CloudEngineHub/LeRobot-Anything-U-Arm/src/simulation/mani_skill/agents/robots/humanoid/mujoco_humanoid.png

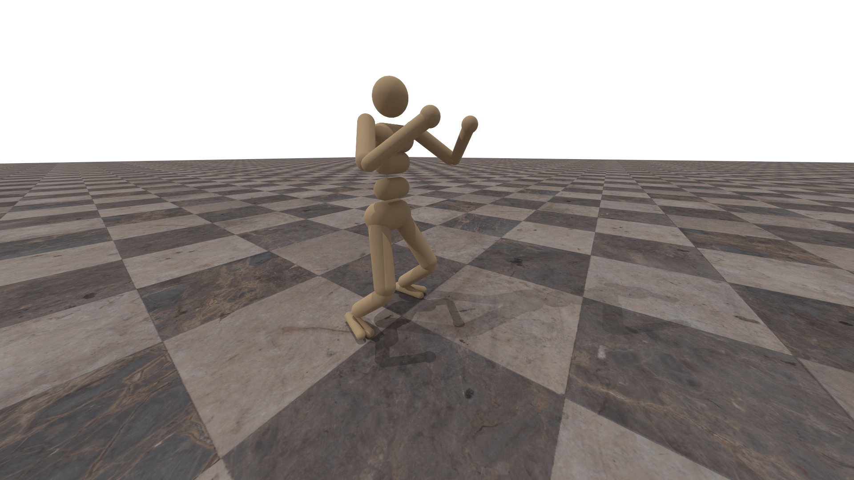
src/simulation/mani_skill/agents/robots/humanoid/mujoco_humanoid.png
