CloudEngineHub/LeRobot-Anything-U-Arm/src/simulation/mani_skill/assets/robots/fetch/fetch_description/meshes/elbow_flex_uv.png

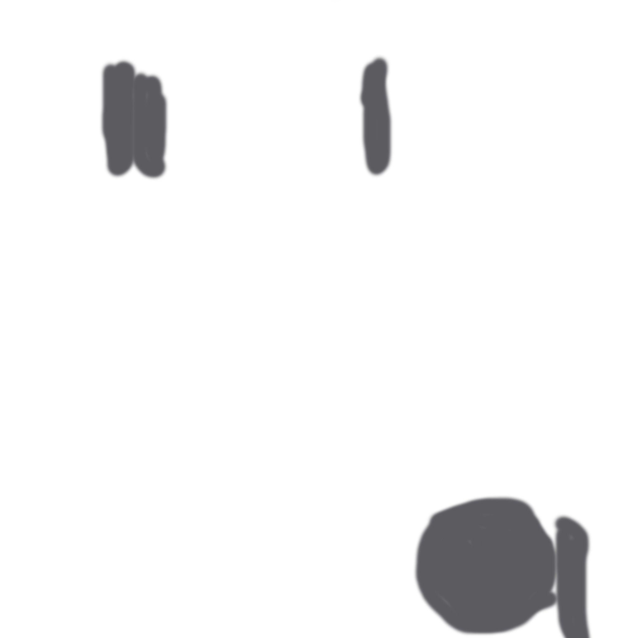
src/simulation/mani_skill/assets/robots/fetch/fetch_description/meshes/elbow_flex_uv.png
