CloudEngineHub/LeRobot-Anything-U-Arm/src/simulation/mani_skill/envs/tasks/humanoid/assets/cardboard_box/01.png

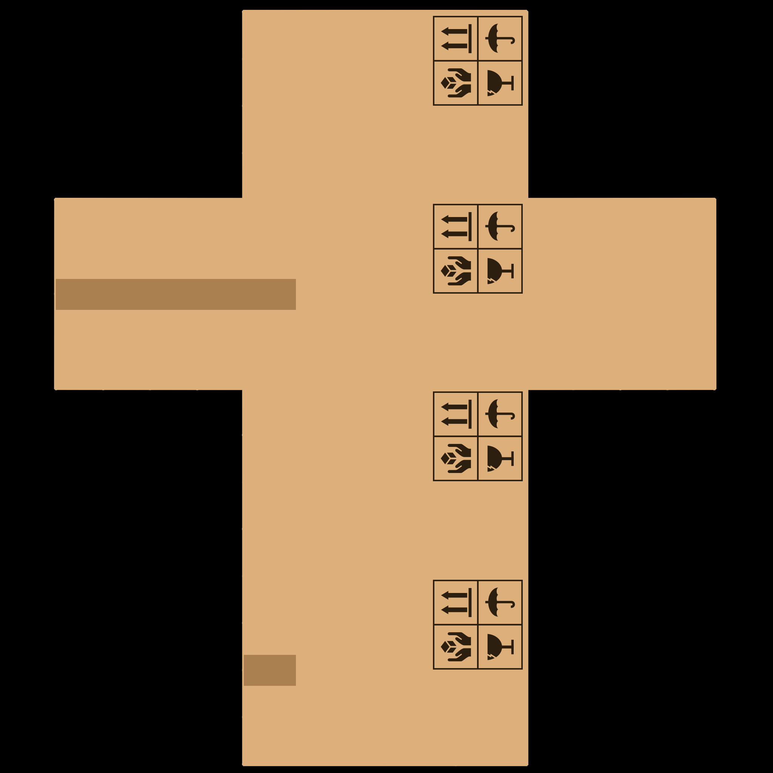
src/simulation/mani_skill/envs/tasks/humanoid/assets/cardboard_box/01.png
