CloudEngineHub/LeRobot-Anything-U-Arm/src/simulation/mani_skill/assets/robots/trifinger/robot_properties_fingers/meshes/BL-M_Table_ASM_small.stl

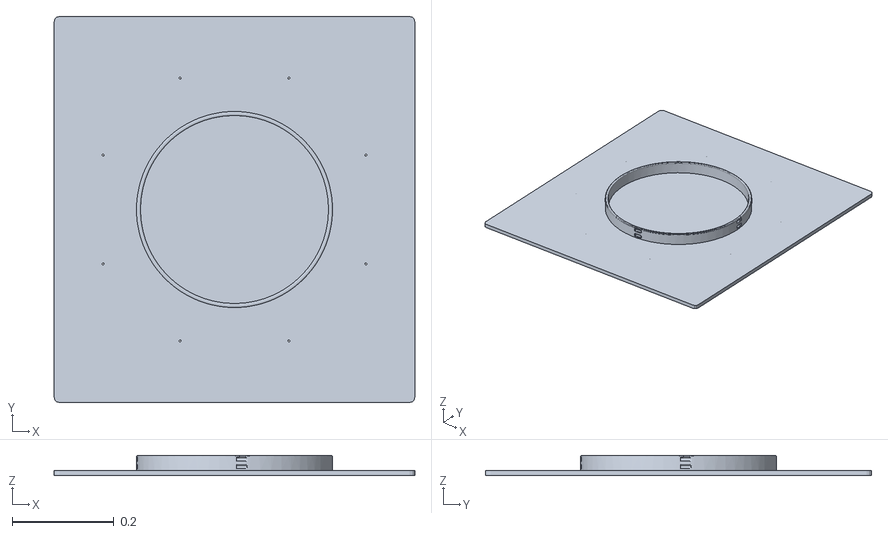
[picture p19: CAD file, 2025-08-23]
src/simulation/mani_skill/assets/robots/trifinger/robot_properties_fingers/meshes/BL-M_Table_ASM_small.stl
0.71 x 0.76 x 0.04
