CloudEngineHub/LeRobot-Anything-U-Arm/mechanical/Zhonglin_servo/dual_arm/franka_teleop_middle_bridge.STL

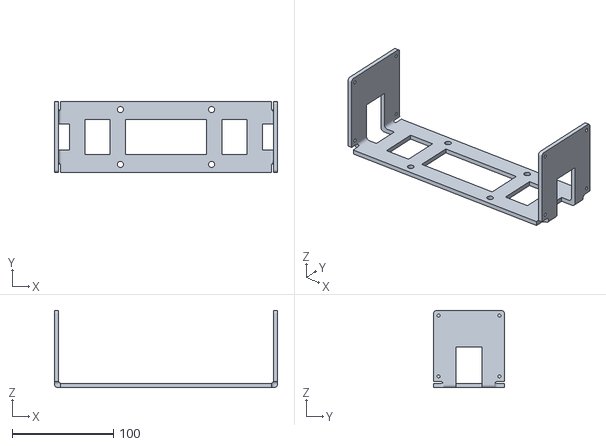
[picture p20: CAD file, 2026-03-27]
mechanical/Zhonglin_servo/dual_arm/franka_teleop_middle_bridge.STL
220.0 x 70.0 x 76.0
