CloudEngineHub/LeRobot-Anything-U-Arm/src/simulation/mani_skill/assets/robots/ability_hand/meshes/collision/thumb-F2_C.obj

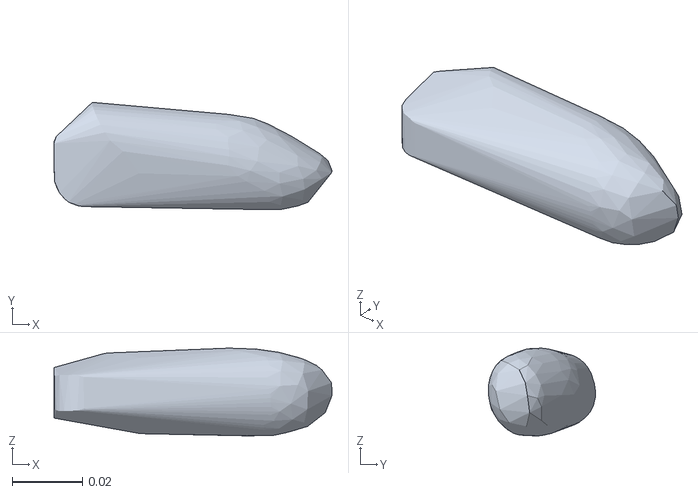
[picture p21: CAD file, 2025-08-23]
src/simulation/mani_skill/assets/robots/ability_hand/meshes/collision/thumb-F2_C.obj
0.0793 x 0.0306 x 0.025
