CloudEngineHub/LeRobot-Anything-U-Arm/src/simulation/mani_skill/assets/robots/ability_hand/meshes/visual/FB_palm_ref_MIR.obj

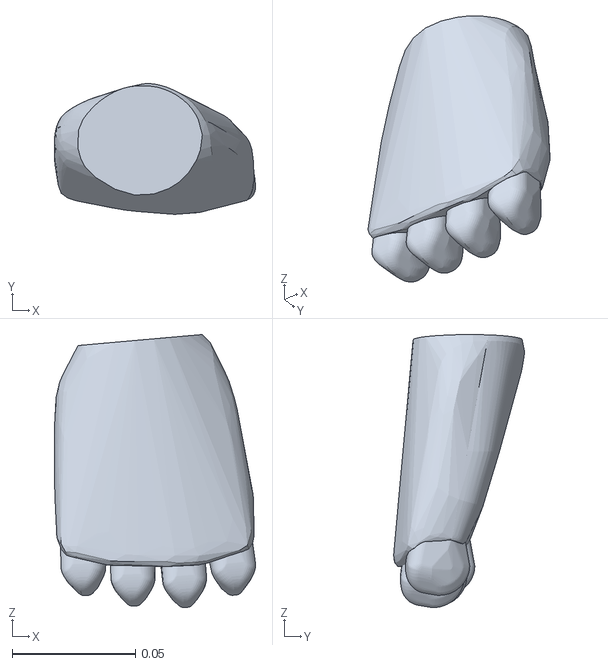
[picture p22: CAD file, 2025-08-23]
src/simulation/mani_skill/assets/robots/ability_hand/meshes/visual/FB_palm_ref_MIR.obj
0.0816 x 0.053 x 0.111
