CloudEngineHub/LeRobot-Anything-U-Arm/src/simulation/mani_skill/assets/robots/allegro/meshes/collision/link_tip.obj

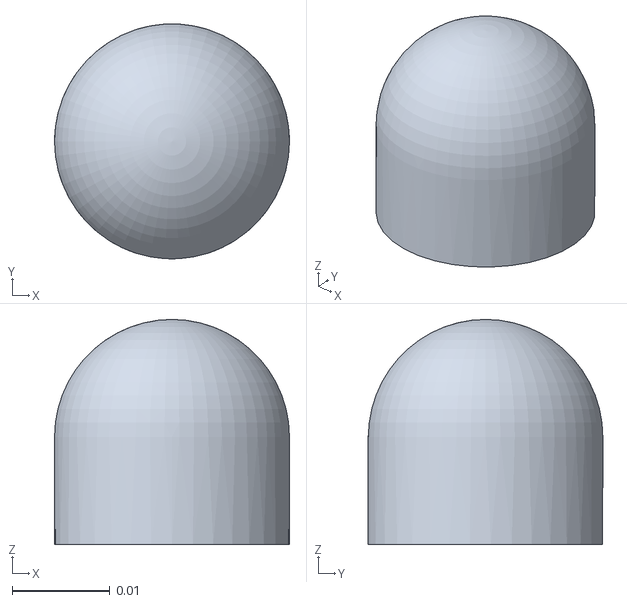
[picture p23: CAD file, 2025-08-23]
src/simulation/mani_skill/assets/robots/allegro/meshes/collision/link_tip.obj
0.024 x 0.024 x 0.023
