CloudEngineHub/LeRobot-Anything-U-Arm/src/simulation/mani_skill/assets/robots/allegro/meshes/visual/link_13.0.obj

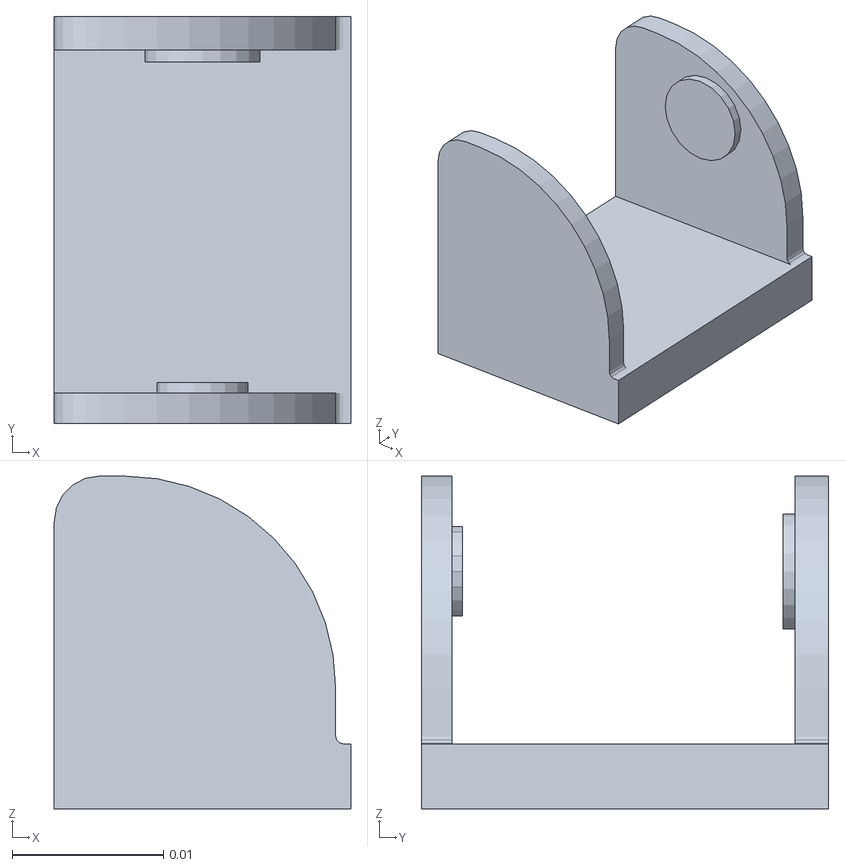
[picture p24: CAD file, 2025-08-23]
src/simulation/mani_skill/assets/robots/allegro/meshes/visual/link_13.0.obj
0.0196 x 0.0269 x 0.022
