CloudEngineHub/LeRobot-Anything-U-Arm/src/simulation/mani_skill/assets/robots/allegro/variation/meshes/collision/longer_finger_tip.obj

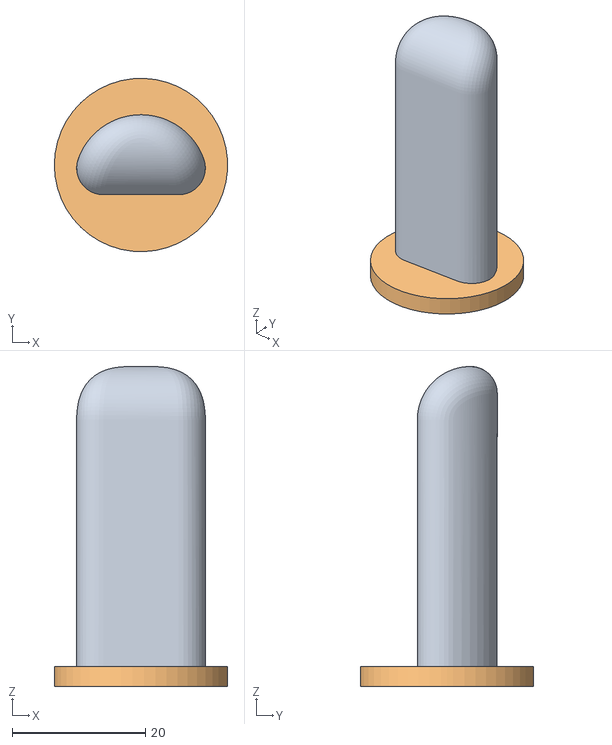
[picture p25: CAD file, 2025-08-23]
src/simulation/mani_skill/assets/robots/allegro/variation/meshes/collision/longer_finger_tip.obj
26.0 x 26.0 x 48.0
geometry_0
geometry_1
