CloudEngineHub/LeRobot-Anything-U-Arm/src/simulation/mani_skill/assets/robots/allegro/variation/meshes/visual/tactile.obj

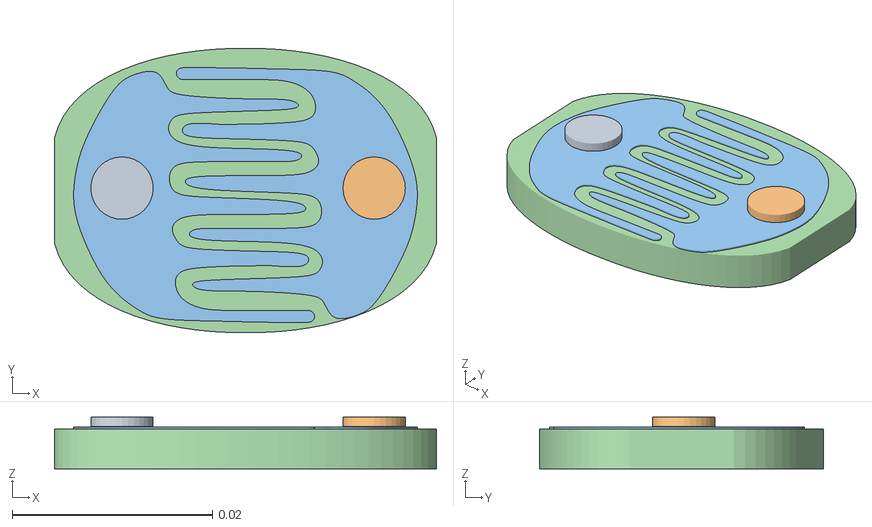
[picture p26: CAD file, 2025-08-23]
src/simulation/mani_skill/assets/robots/allegro/variation/meshes/visual/tactile.obj
0.0382 x 0.0284 x 0.00519
LIGHT_CATCHER_2
photocell
