CloudEngineHub/LeRobot-Anything-U-Arm/src/simulation/mani_skill/assets/robots/ARX-X5/meshes/link3.STL

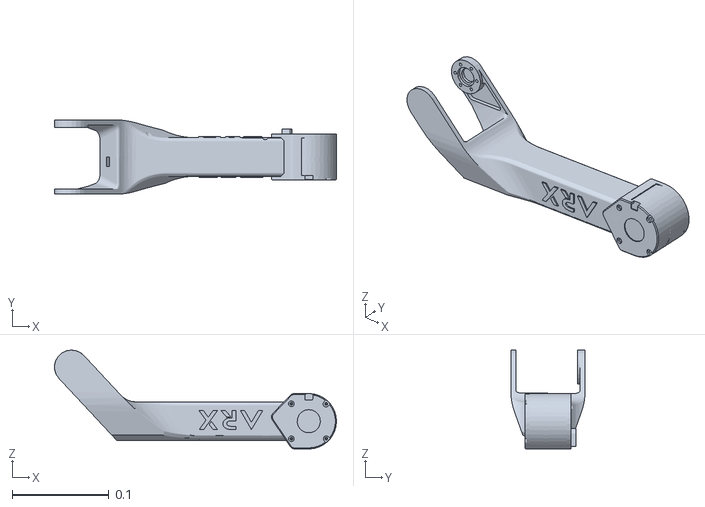
[picture p27: CAD file, 2025-08-23]
src/simulation/mani_skill/assets/robots/ARX-X5/meshes/link3.STL
0.291 x 0.0765 x 0.102
