CloudEngineHub/LeRobot-Anything-U-Arm/src/simulation/mani_skill/assets/robots/dclaw/meshes/collision/finger_tip.obj

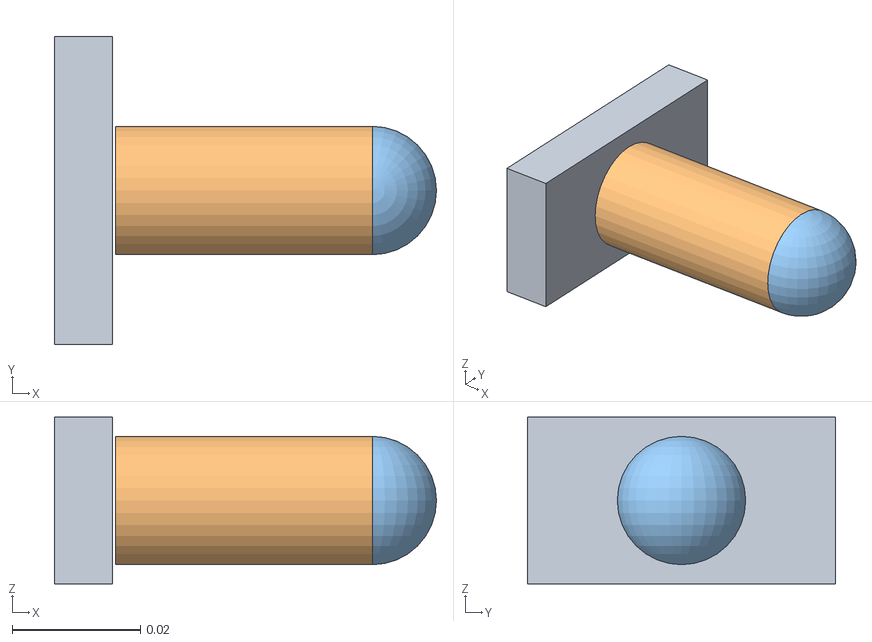
[picture p28: CAD file, 2025-08-23]
src/simulation/mani_skill/assets/robots/dclaw/meshes/collision/finger_tip.obj
0.0595 x 0.048 x 0.026
