CloudEngineHub/LeRobot-Anything-U-Arm/src/simulation/mani_skill/assets/robots/dclaw/meshes/visual/link_1.obj

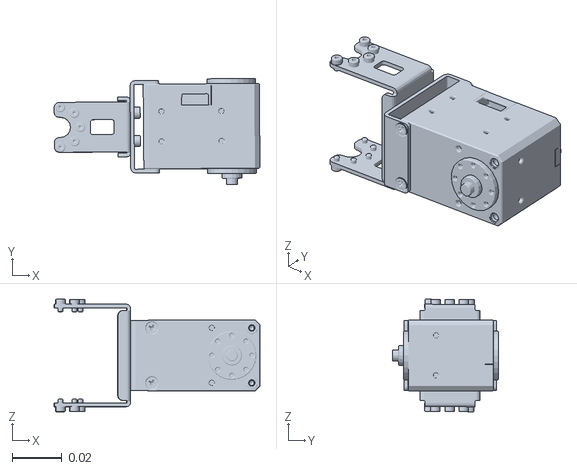
[picture p29: CAD file, 2025-08-23]
src/simulation/mani_skill/assets/robots/dclaw/meshes/visual/link_1.obj
0.0824 x 0.0425 x 0.045
