CloudEngineHub/LeRobot-Anything-U-Arm/src/simulation/mani_skill/assets/robots/fetch/fetch_description/meshes/l_gripper_finger_link.STL

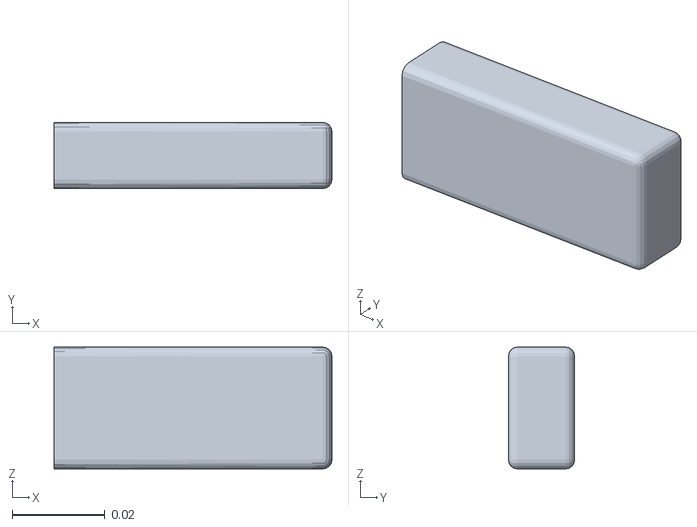
[picture p30: CAD file, 2025-08-23]
src/simulation/mani_skill/assets/robots/fetch/fetch_description/meshes/l_gripper_finger_link.STL
0.06 x 0.0143 x 0.0263
