CloudEngineHub/LeRobot-Anything-U-Arm/src/simulation/mani_skill/assets/robots/fetch_xlerobot/meshes/Fixed_Jaw_part1.ply.convex.stl

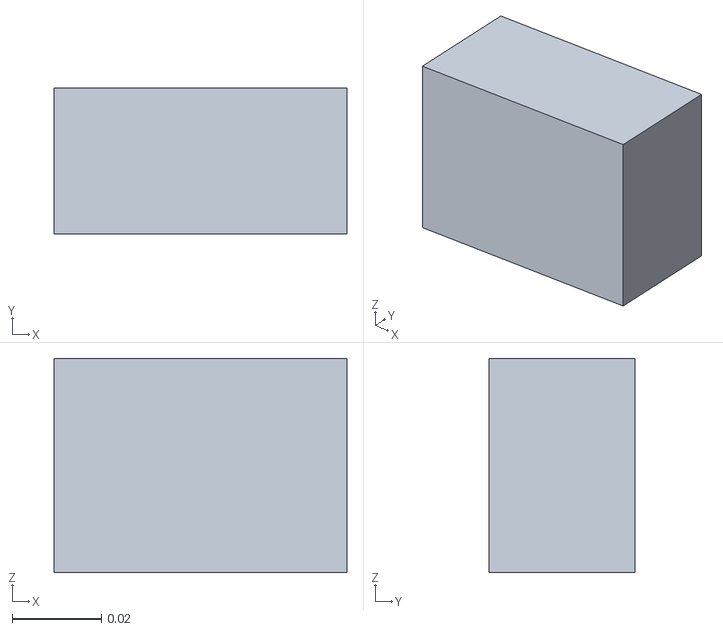
[picture p31: CAD file, 2025-08-23]
src/simulation/mani_skill/assets/robots/fetch_xlerobot/meshes/Fixed_Jaw_part1.ply.convex.stl
0.0656 x 0.0328 x 0.048
