CloudEngineHub/LeRobot-Anything-U-Arm/src/simulation/mani_skill/assets/robots/g1_humanoid/meshes/right_two_link.STL

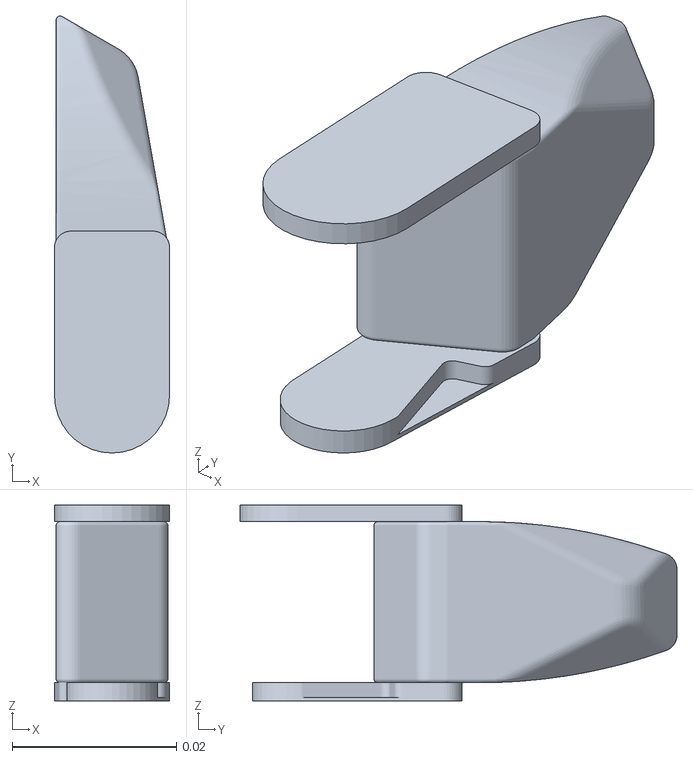
[picture p32: CAD file, 2025-08-23]
src/simulation/mani_skill/assets/robots/g1_humanoid/meshes/right_two_link.STL
0.014 x 0.0532 x 0.0238
