CloudEngineHub/LeRobot-Anything-U-Arm/src/simulation/mani_skill/assets/robots/koch/meshes/link_2.stl

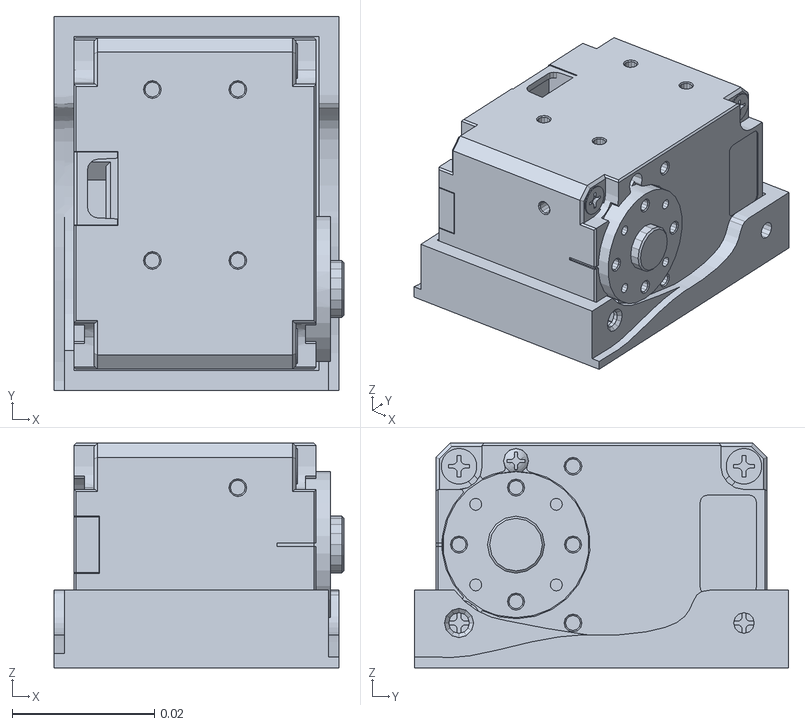
[picture p33: CAD file, 2025-08-23]
src/simulation/mani_skill/assets/robots/koch/meshes/link_2.stl
0.0407 x 0.0525 x 0.0316
