CloudEngineHub/LeRobot-Anything-U-Arm/src/simulation/mani_skill/assets/robots/panda/franka_description/meshes/collision/link6.stl.convex.stl

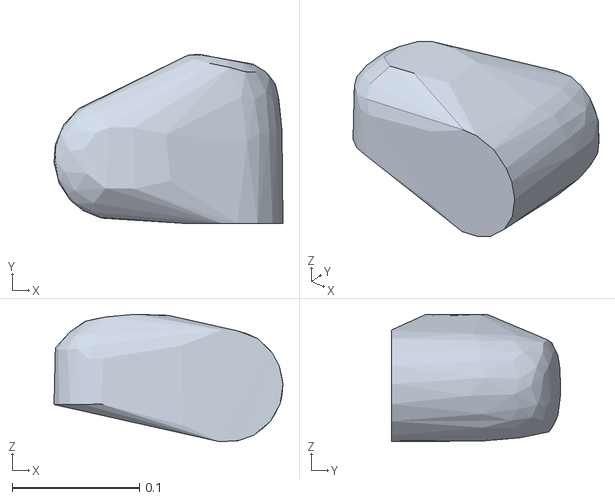
[picture p34: CAD file, 2025-08-23]
src/simulation/mani_skill/assets/robots/panda/franka_description/meshes/collision/link6.stl.convex.stl
0.18 x 0.133 x 0.1
