CloudEngineHub/LeRobot-Anything-U-Arm/src/simulation/mani_skill/assets/robots/panda/realsense2_description/meshes/plug_collision.stl

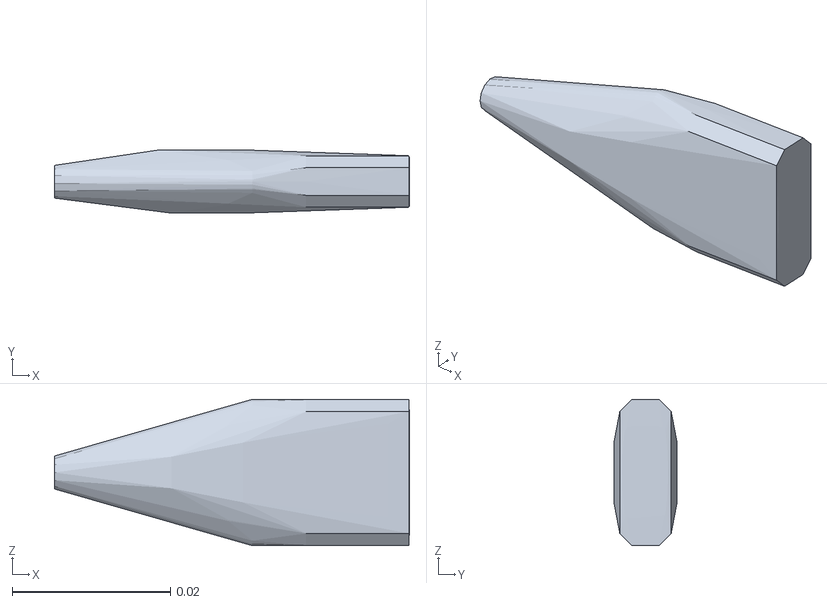
[picture p35: CAD file, 2025-08-23]
src/simulation/mani_skill/assets/robots/panda/realsense2_description/meshes/plug_collision.stl
0.0448 x 0.008 x 0.0185
