CloudEngineHub/LeRobot-Anything-U-Arm/src/simulation/mani_skill/assets/robots/panda/sciurus17_description/meshes/collision/Body.stl

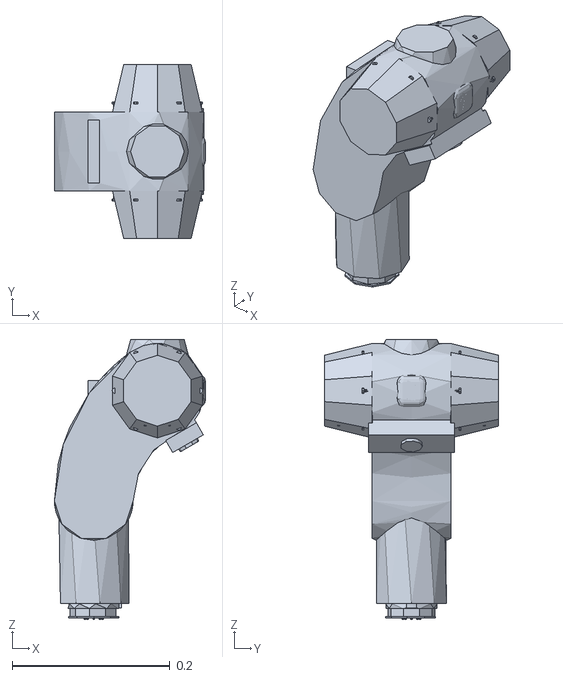
[picture p36: CAD file, 2025-08-23]
src/simulation/mani_skill/assets/robots/panda/sciurus17_description/meshes/collision/Body.stl
0.192 x 0.221 x 0.356
