CloudEngineHub/LeRobot-Anything-U-Arm/src/simulation/mani_skill/assets/robots/panda/sciurus17_description/meshes/visual/Base.stl

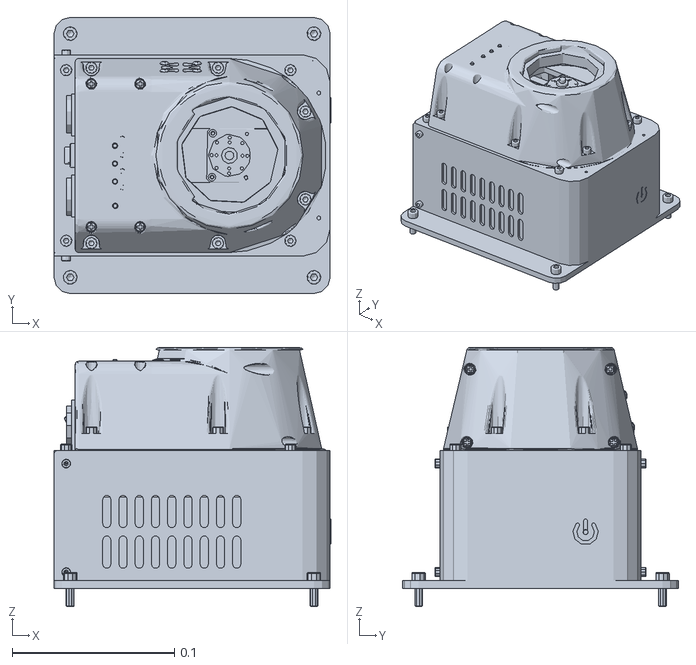
[picture p37: CAD file, 2025-08-23]
src/simulation/mani_skill/assets/robots/panda/sciurus17_description/meshes/visual/Base.stl
0.171 x 0.17 x 0.159
