CloudEngineHub/LeRobot-Anything-U-Arm/src/simulation/mani_skill/assets/robots/piper/meshes/link1.STL

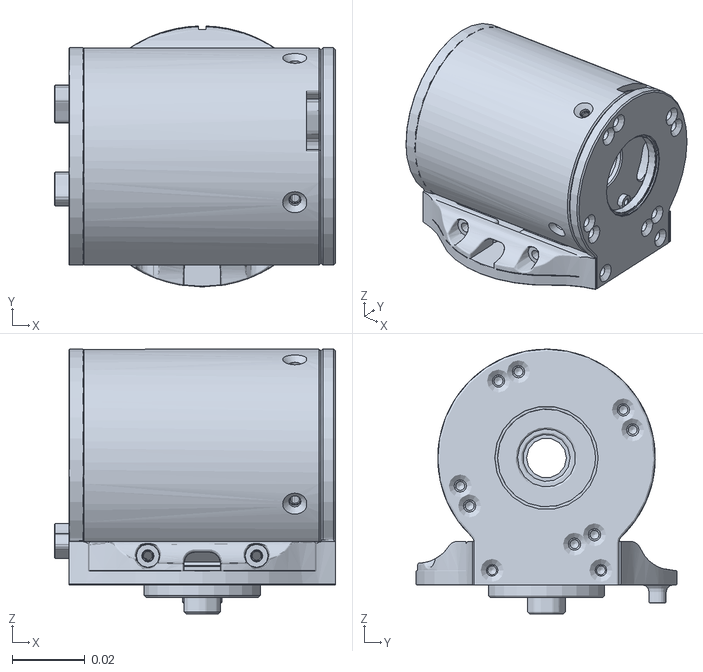
[picture p38: CAD file, 2025-08-23]
src/simulation/mani_skill/assets/robots/piper/meshes/link1.STL
0.0775 x 0.072 x 0.073
