CloudEngineHub/LeRobot-Anything-U-Arm/src/simulation/mani_skill/assets/robots/so100/meshes/Base.stl

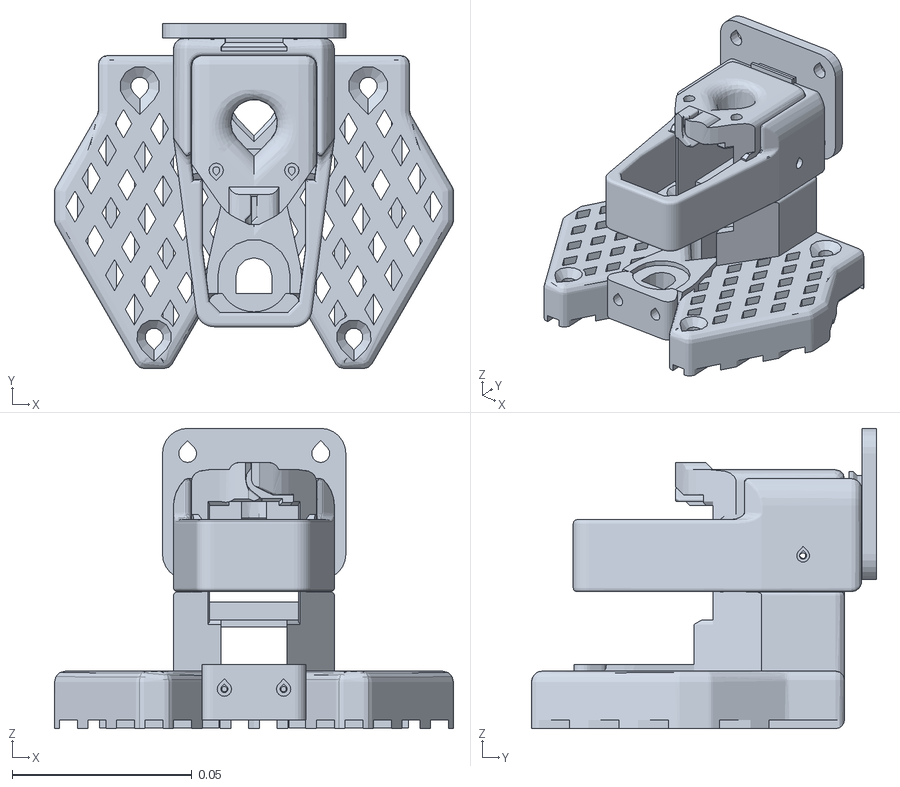
[picture p39: CAD file, 2025-08-23]
src/simulation/mani_skill/assets/robots/so100/meshes/Base.stl
0.111 x 0.0959 x 0.0835
