CloudEngineHub/LeRobot-Anything-U-Arm/src/simulation/mani_skill/assets/robots/trifinger/objects/meshes/ball.obj

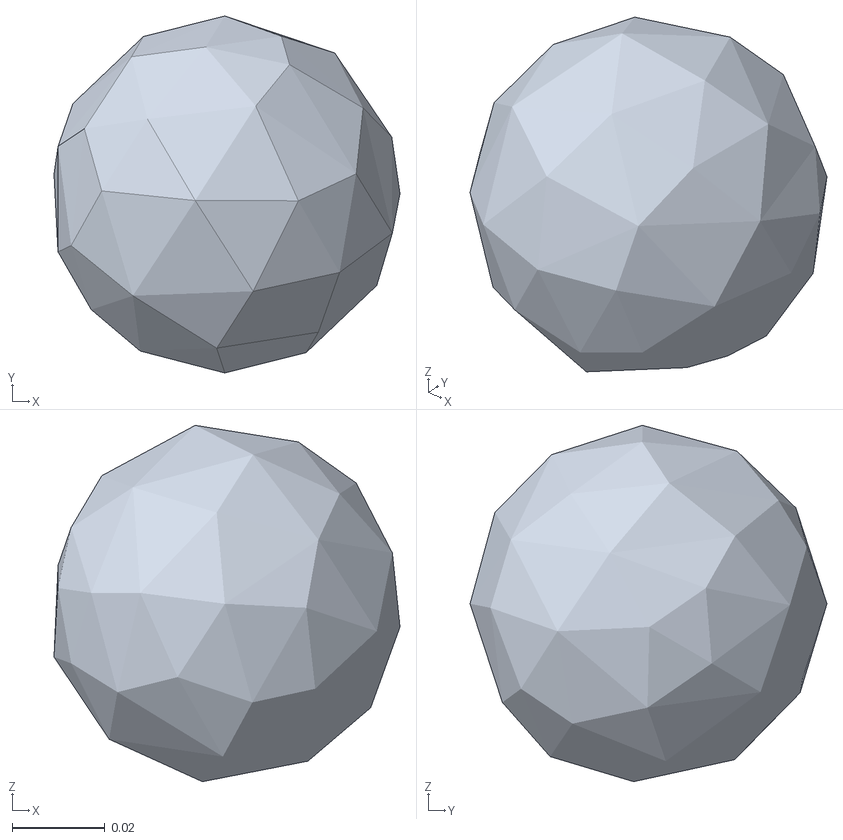
[picture p40: CAD file, 2025-08-23]
src/simulation/mani_skill/assets/robots/trifinger/objects/meshes/ball.obj
0.0745 x 0.0768 x 0.0767
