CloudEngineHub/LeRobot-Anything-U-Arm/src/simulation/mani_skill/assets/robots/trifinger/robot_properties_fingers/meshes/edu/base_side_right.stl

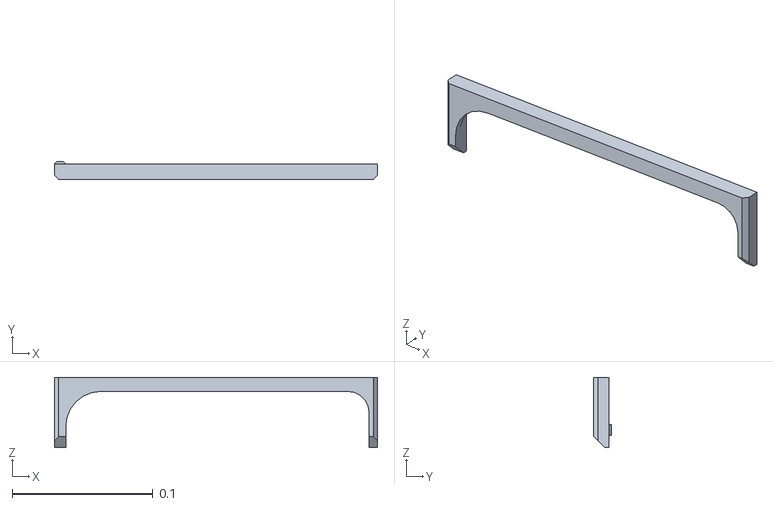
[picture p41: CAD file, 2025-08-23]
src/simulation/mani_skill/assets/robots/trifinger/robot_properties_fingers/meshes/edu/base_side_right.stl
0.229 x 0.0125 x 0.05
