CloudEngineHub/LeRobot-Anything-U-Arm/src/simulation/mani_skill/assets/robots/trifinger/robot_properties_fingers/meshes/pro/detailed/SIM__BL-Finger_Tip_without_tip.stl

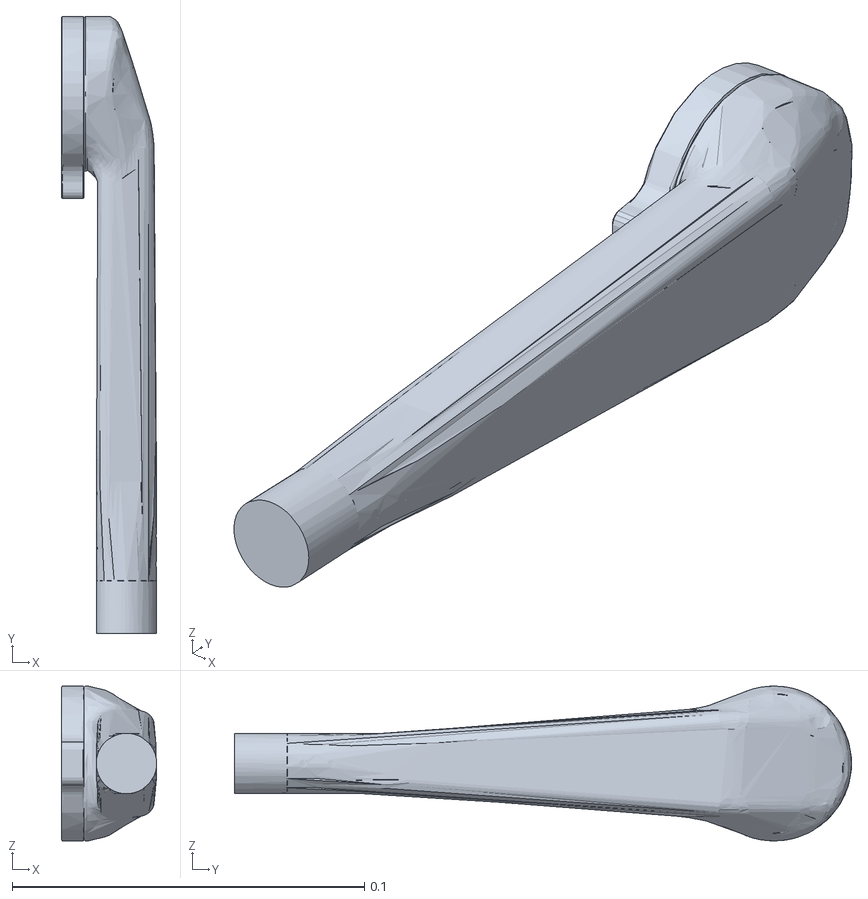
[picture p42: CAD file, 2025-08-23]
src/simulation/mani_skill/assets/robots/trifinger/robot_properties_fingers/meshes/pro/detailed/SIM__BL-Finger_Tip_without_tip.stl
0.0271 x 0.175 x 0.044
