CloudEngineHub/LeRobot-Anything-U-Arm/src/simulation/mani_skill/assets/robots/trifinger/robot_properties_fingers/meshes/pro/motor_sim.stl

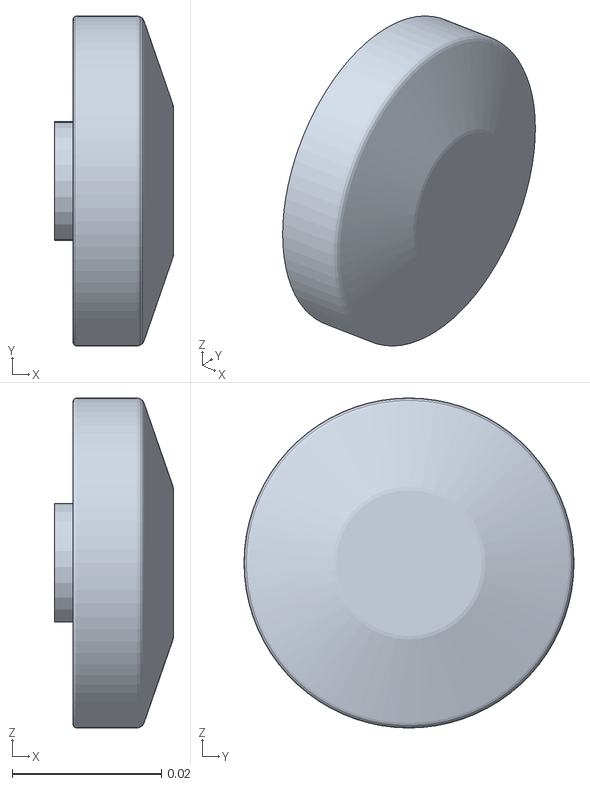
[picture p43: CAD file, 2025-08-23]
src/simulation/mani_skill/assets/robots/trifinger/robot_properties_fingers/meshes/pro/motor_sim.stl
0.016 x 0.0442 x 0.0442
