CloudEngineHub/LeRobot-Anything-U-Arm/src/simulation/mani_skill/assets/robots/trifinger/robot_properties_fingers/meshes/Tip_link_Modular_SIM.stl

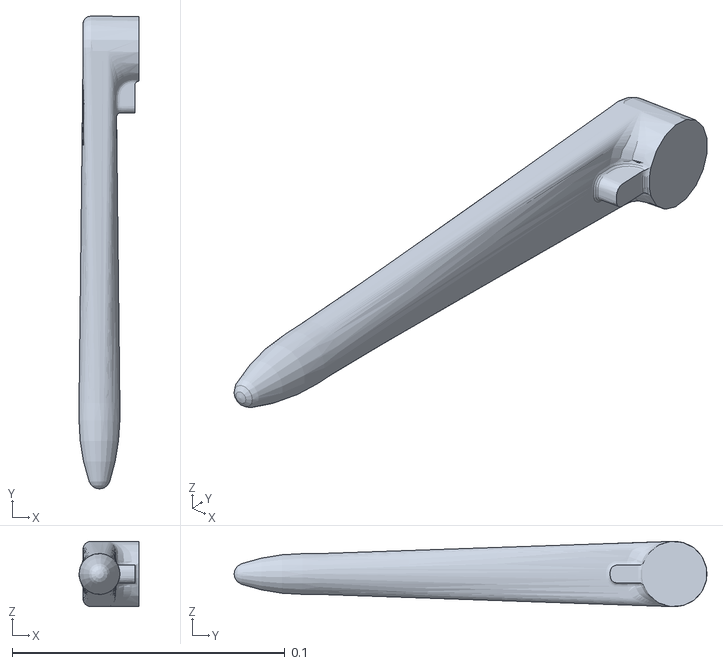
[picture p44: CAD file, 2025-08-23]
src/simulation/mani_skill/assets/robots/trifinger/robot_properties_fingers/meshes/Tip_link_Modular_SIM.stl
0.022 x 0.174 x 0.024
