CloudEngineHub/LeRobot-Anything-U-Arm/src/simulation/mani_skill/assets/robots/xarm7/meshes/collision/link2.obj

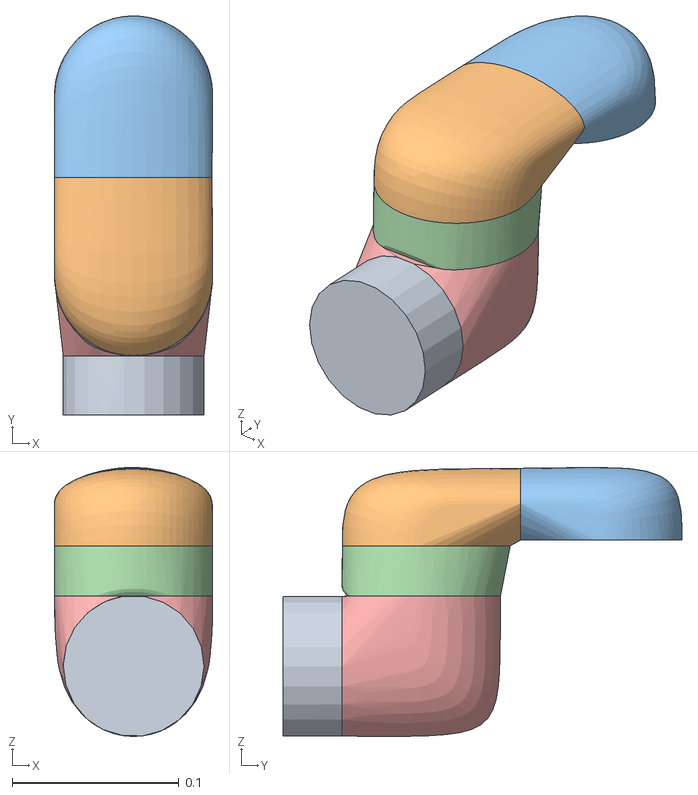
[picture p45: CAD file, 2025-08-23]
src/simulation/mani_skill/assets/robots/xarm7/meshes/collision/link2.obj
0.095 x 0.239 x 0.161
geometry_0
geometry_1
geometry_2
geometry_3
geometry_4
