CloudEngineHub/LeRobot-Anything-U-Arm/src/simulation/mani_skill/envs/tasks/fmb/assets/purple_u.ply

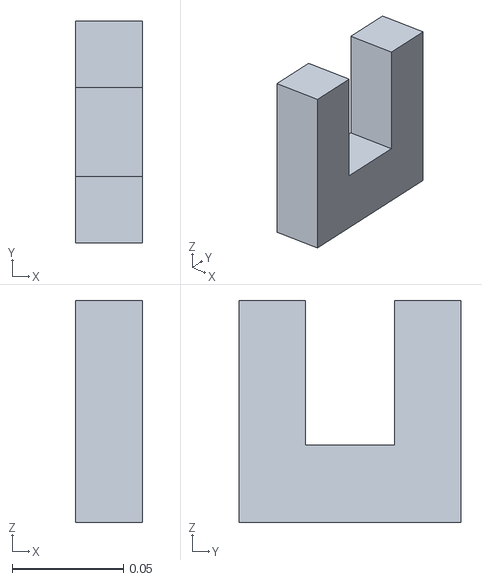
[picture p46: CAD file, 2025-08-23]
src/simulation/mani_skill/envs/tasks/fmb/assets/purple_u.ply
0.03 x 0.1 x 0.1
