CloudEngineHub/LeRobot-Anything-U-Arm/src/simulation/mani_skill/envs/tasks/humanoid/assets/apple_1.ply

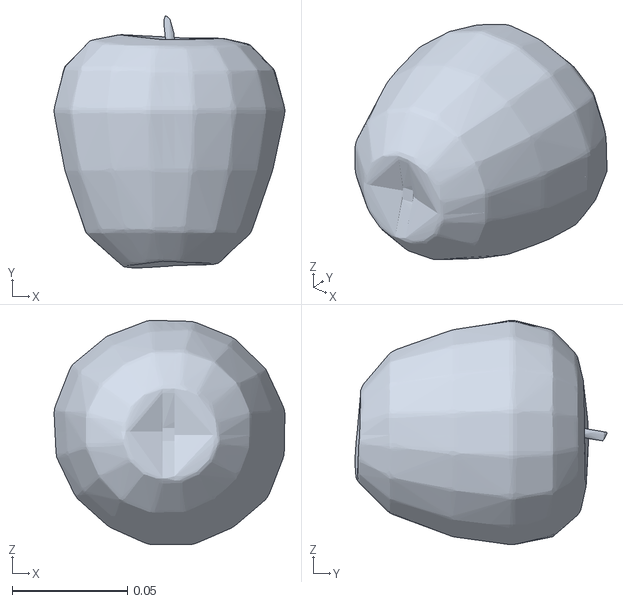
[picture p47: CAD file, 2025-08-23]
src/simulation/mani_skill/envs/tasks/humanoid/assets/apple_1.ply
0.1 x 0.11 x 0.0975
