CloudEngineHub/LeRobot-Anything-U-Arm/src/simulation/mani_skill/envs/tasks/humanoid/assets/cardboard_box/textured.obj

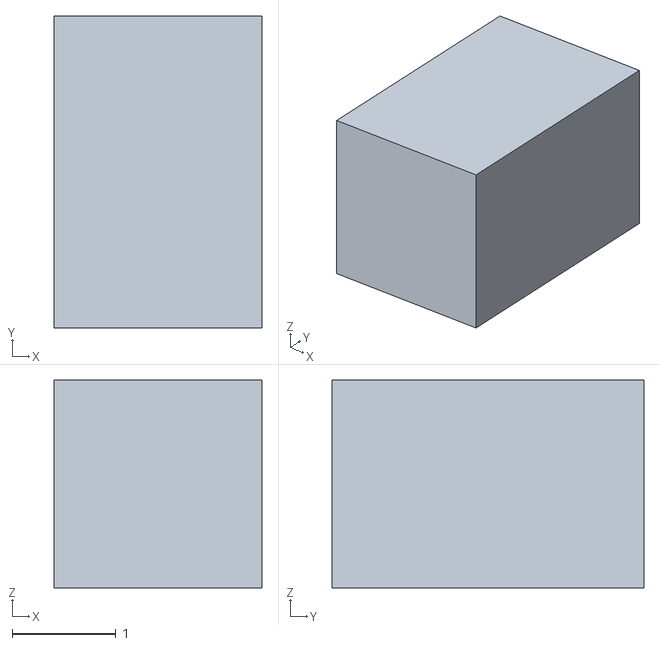
[picture p48: CAD file, 2025-08-23]
src/simulation/mani_skill/envs/tasks/humanoid/assets/cardboard_box/textured.obj
2.00 x 3.00 x 2.00
