CloudEngineHub/LeRobot-Anything-U-Arm/src/simulation/mani_skill/examples/bimanual.openarm/openarm_description/assets/end_effector/parallel_link/meshes/collision/finger.stl

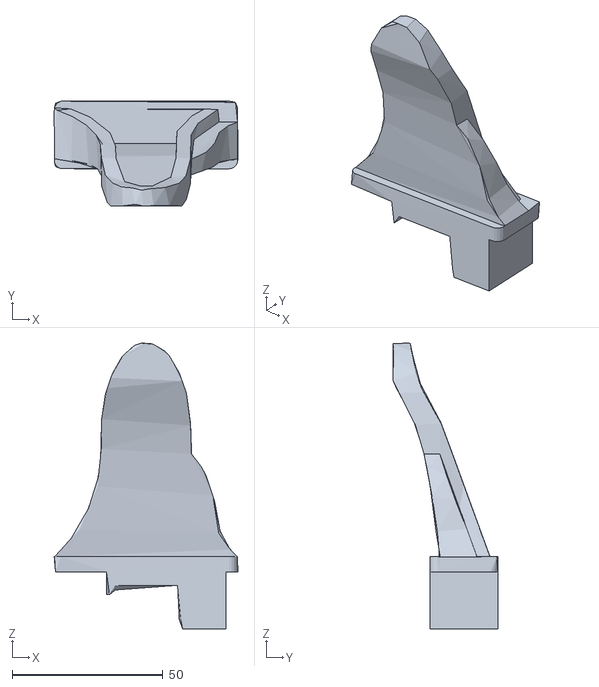
[picture p49: CAD file, 2026-07-15]
src/simulation/mani_skill/examples/bimanual.openarm/openarm_description/assets/end_effector/parallel_link/meshes/collision/finger.stl
61.0 x 34.8 x 94.9
