CloudEngineHub/LeRobot-Anything-U-Arm/src/simulation/mani_skill/examples/bimanual.openarm/openarm_description/assets/end_effector/parallel_link/meshes/visual/finger.stl

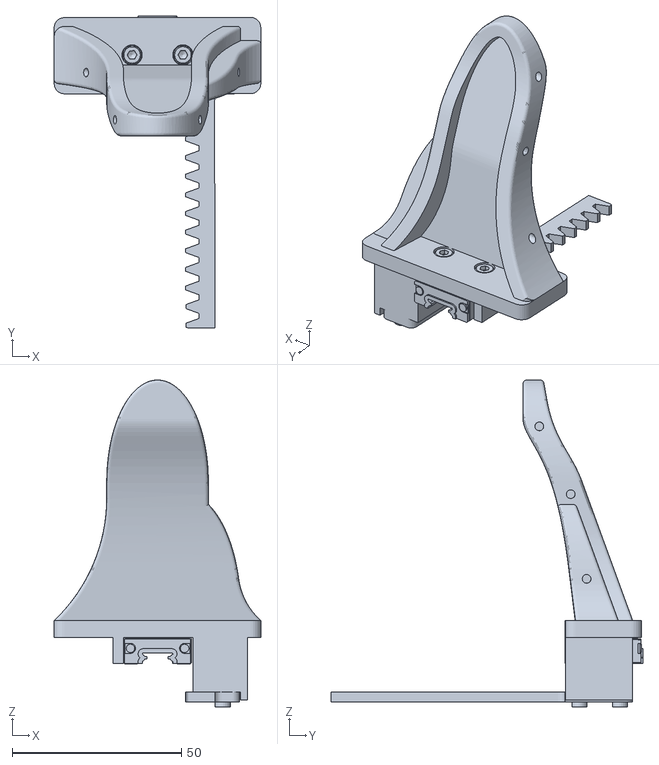
[picture p50: CAD file, 2026-07-15]
src/simulation/mani_skill/examples/bimanual.openarm/openarm_description/assets/end_effector/parallel_link/meshes/visual/finger.stl
61.0 x 92.0 x 96.5
