CloudEngineHub/LeRobot-Anything-U-Arm/src/simulation/mani_skill/examples/bimanual.openarm/openarm_description/assets/end_effector/pinch_gripper/meshes/collision/finger_outer.stl

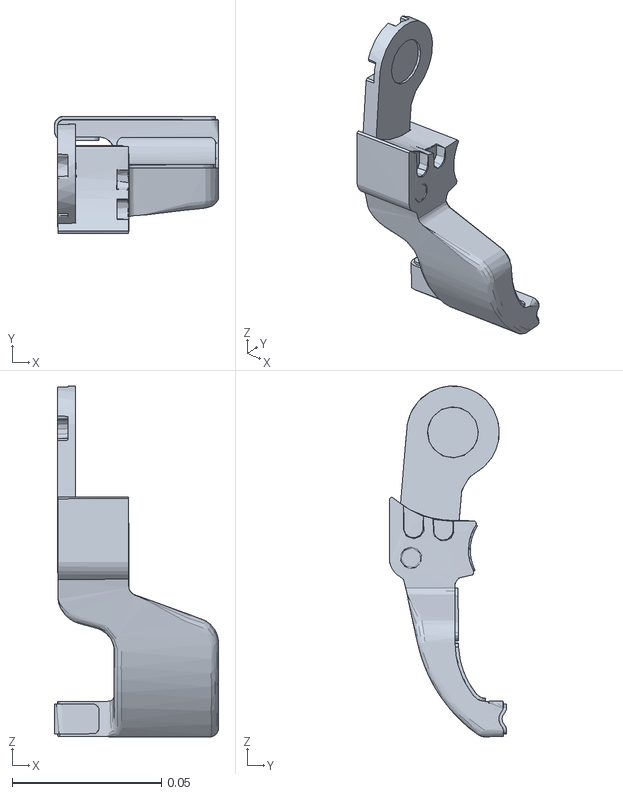
[picture p51: CAD file, 2026-07-15]
src/simulation/mani_skill/examples/bimanual.openarm/openarm_description/assets/end_effector/pinch_gripper/meshes/collision/finger_outer.stl
0.055 x 0.0393 x 0.117
