CloudEngineHub/LeRobot-Anything-U-Arm/src/simulation/mani_skill/examples/bimanual.openarm/openarm_description/assets/end_effector/pinch_gripper/meshes/collision/splited/finger_inner/finger_inner_01.stl

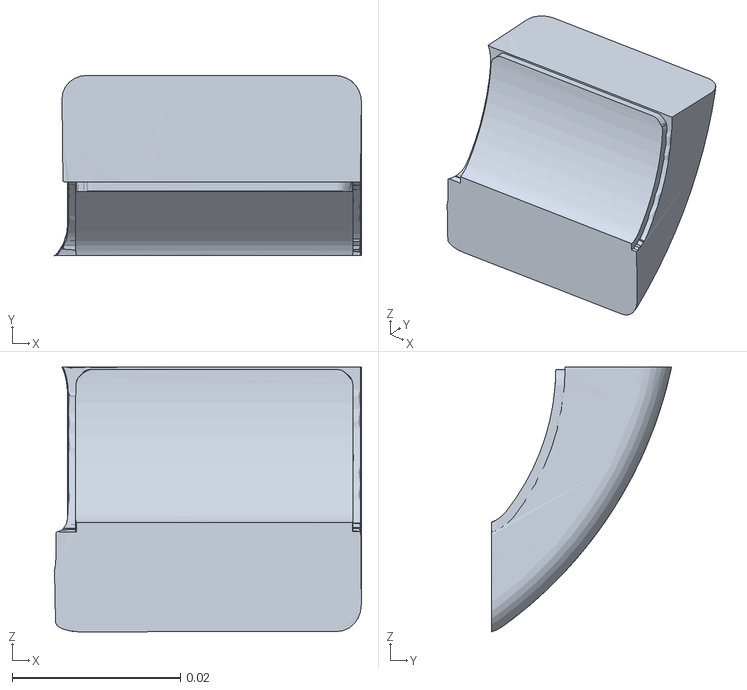
[picture p52: CAD file, 2026-07-15]
src/simulation/mani_skill/examples/bimanual.openarm/openarm_description/assets/end_effector/pinch_gripper/meshes/collision/splited/finger_inner/finger_inner_01.stl
0.0365 x 0.0214 x 0.0315
