CloudEngineHub/LeRobot-Anything-U-Arm/src/simulation/mani_skill/examples/bimanual.openarm/openarm_description/assets/end_effector/pinch_gripper/meshes/collision/splited/finger_outer/finger_outer_03.stl

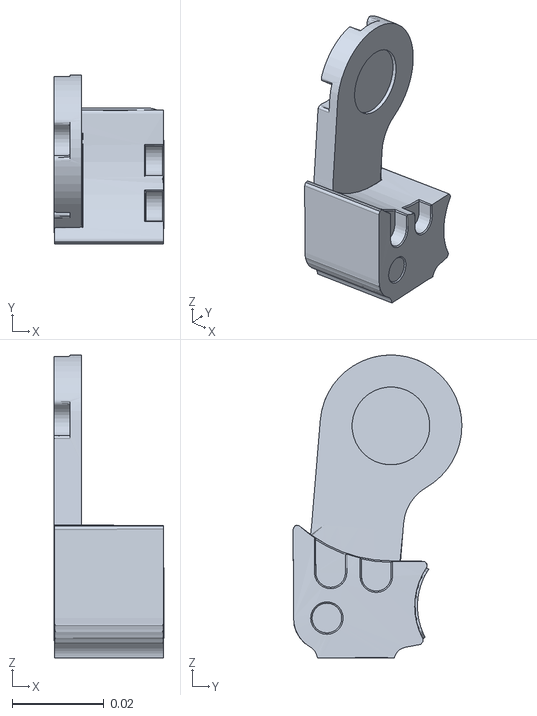
[picture p53: CAD file, 2026-07-15]
src/simulation/mani_skill/examples/bimanual.openarm/openarm_description/assets/end_effector/pinch_gripper/meshes/collision/splited/finger_outer/finger_outer_03.stl
0.024 x 0.0369 x 0.0662
