CloudEngineHub/LeRobot-Anything-U-Arm/src/simulation/mani_skill/examples/bimanual.openarm/openarm_description/assets/robot/openarm_v2.0/meshes/arm/collision/link2.stl

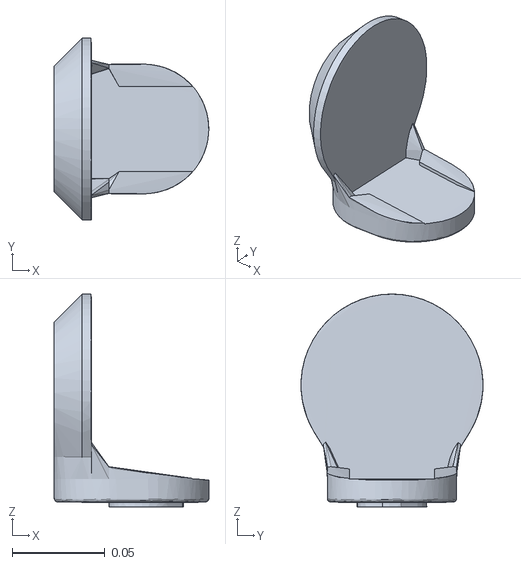
[picture p55: CAD file, 2026-07-15]
src/simulation/mani_skill/examples/bimanual.openarm/openarm_description/assets/robot/openarm_v2.0/meshes/arm/collision/link2.stl
0.0832 x 0.0979 x 0.115
