CloudEngineHub/LeRobot-Anything-U-Arm/src/simulation/mani_skill/examples/bimanual.openarm/openarm_description/assets/robot/openarm_v2.0/meshes/body/collision/body_link0_symp.stl

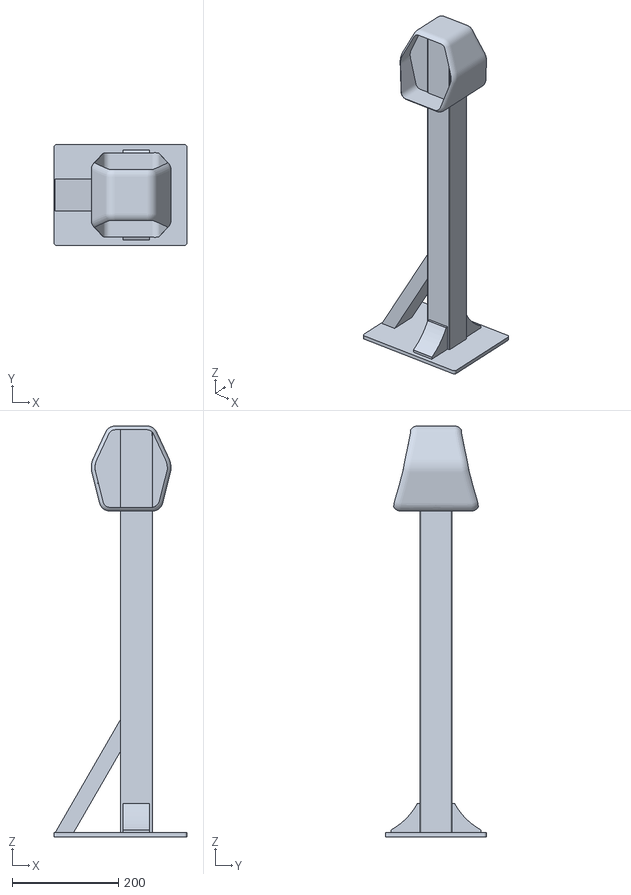
[picture p57: CAD file, 2026-07-15]
src/simulation/mani_skill/examples/bimanual.openarm/openarm_description/assets/robot/openarm_v2.0/meshes/body/collision/body_link0_symp.stl
250.0 x 190.0 x 773.0
