CloudEngineHub/LeRobot-Anything-U-Arm/src/simulation/mani_skill/examples/bimanual.openarm/openarm_description/assets/robot/openarm_v2.0/meshes/body/visual/body_link0.stl

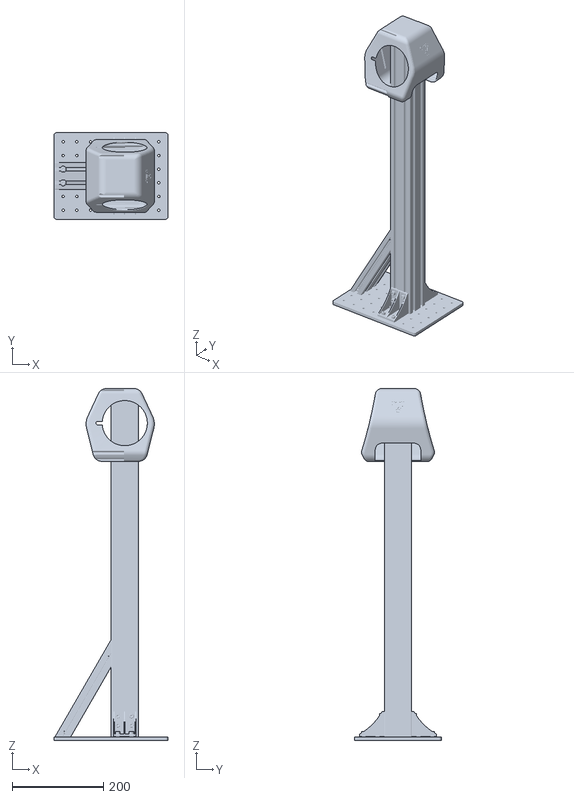
[picture p58: CAD file, 2026-07-15]
src/simulation/mani_skill/examples/bimanual.openarm/openarm_description/assets/robot/openarm_v2.0/meshes/body/visual/body_link0.stl
250.0 x 190.0 x 773.0
