CloudEngineHub/LeRobot-Anything-U-Arm/src/simulation/mani_skill/examples/bimanual.openarm/openarm_mujoco/v2/assets/collision/finger_outer_part_00.stl

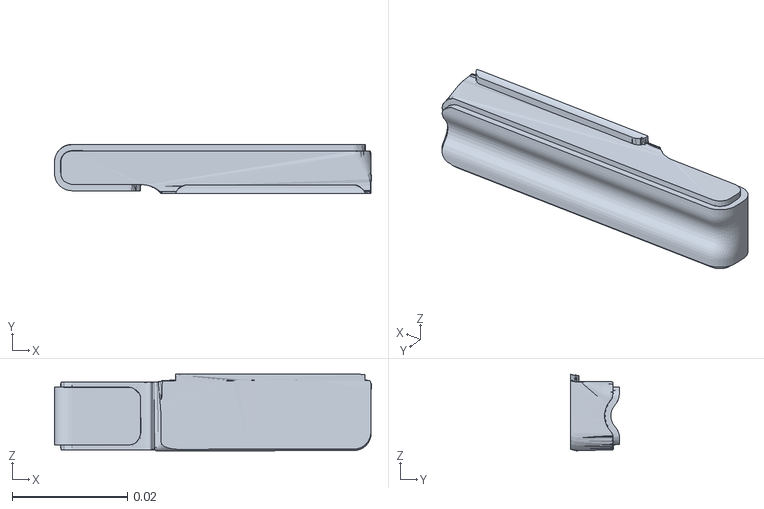
[picture p59: CAD file, 2026-07-15]
src/simulation/mani_skill/examples/bimanual.openarm/openarm_mujoco/v2/assets/collision/finger_outer_part_00.stl
0.055 x 0.00854 x 0.0133
