CloudEngineHub/LeRobot-Anything-U-Arm/src/simulation/mani_skill/examples/bimanual.openarm/openarm_mujoco/v2/assets/visual/arm/link3_02.obj

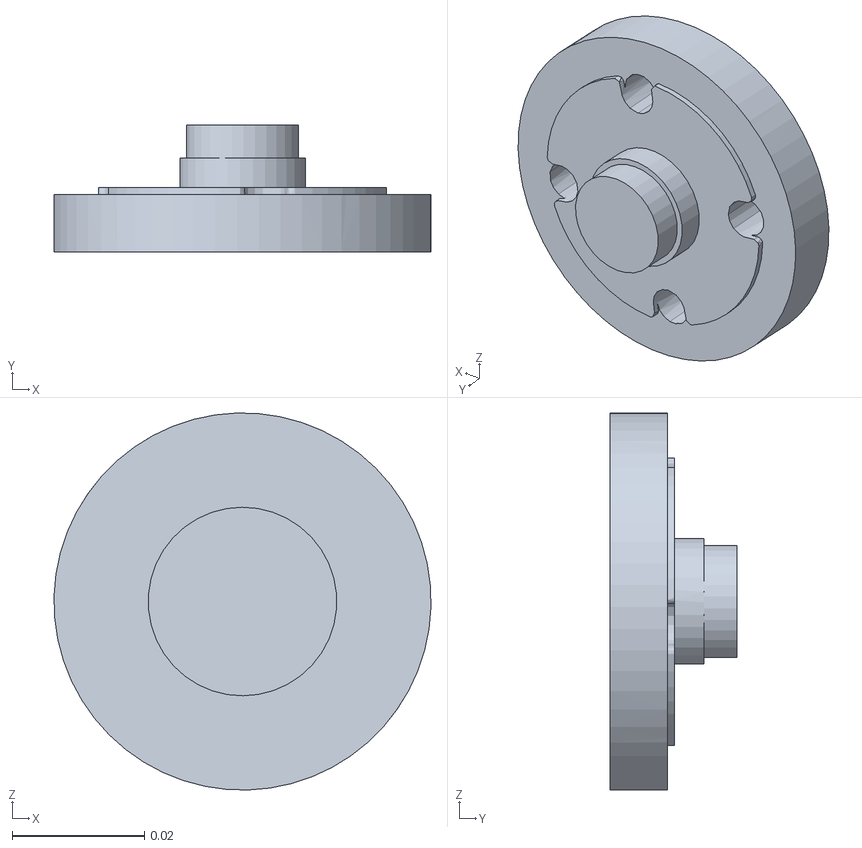
[picture p60: CAD file, 2026-07-15]
src/simulation/mani_skill/examples/bimanual.openarm/openarm_mujoco/v2/assets/visual/arm/link3_02.obj
0.057 x 0.0193 x 0.057
