CloudEngineHub/LeRobot-Anything-U-Arm/src/simulation/mani_skill/examples/bimanual.openarm/openarm_mujoco/v2/assets/visual/cell/cell.obj

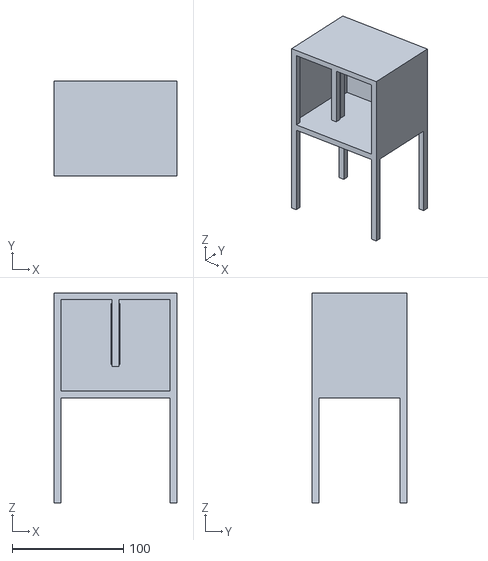
[picture p61: CAD file, 2026-07-15]
src/simulation/mani_skill/examples/bimanual.openarm/openarm_mujoco/v2/assets/visual/cell/cell.obj
110.0 x 85.0 x 188.6
