CloudEngineHub/LeRobot-Anything-U-Arm/src/simulation/mani_skill/examples/bimanual.openarm/openarm_mujoco/v2/assets/visual/gripper/ee_base_link_00.obj

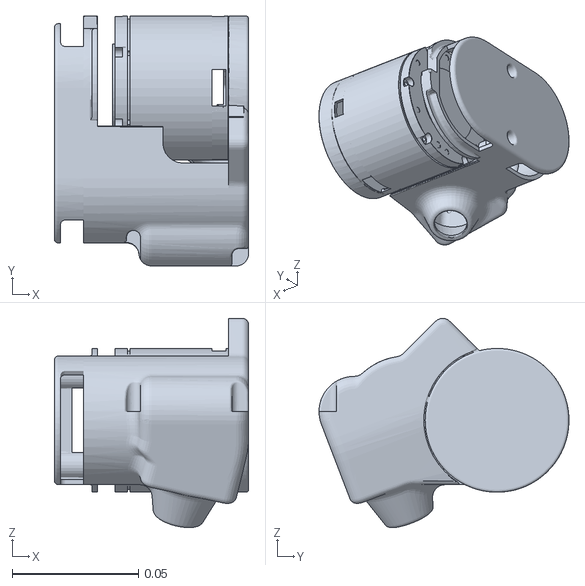
[picture p62: CAD file, 2026-07-15]
src/simulation/mani_skill/examples/bimanual.openarm/openarm_mujoco/v2/assets/visual/gripper/ee_base_link_00.obj
0.077 x 0.0991 x 0.083
