CloudEngineHub/LeRobot-Anything-U-Arm/mechanical/Zhonglin_servo/dual_arm/frank_teleop_humanoid_bimanual.STEP

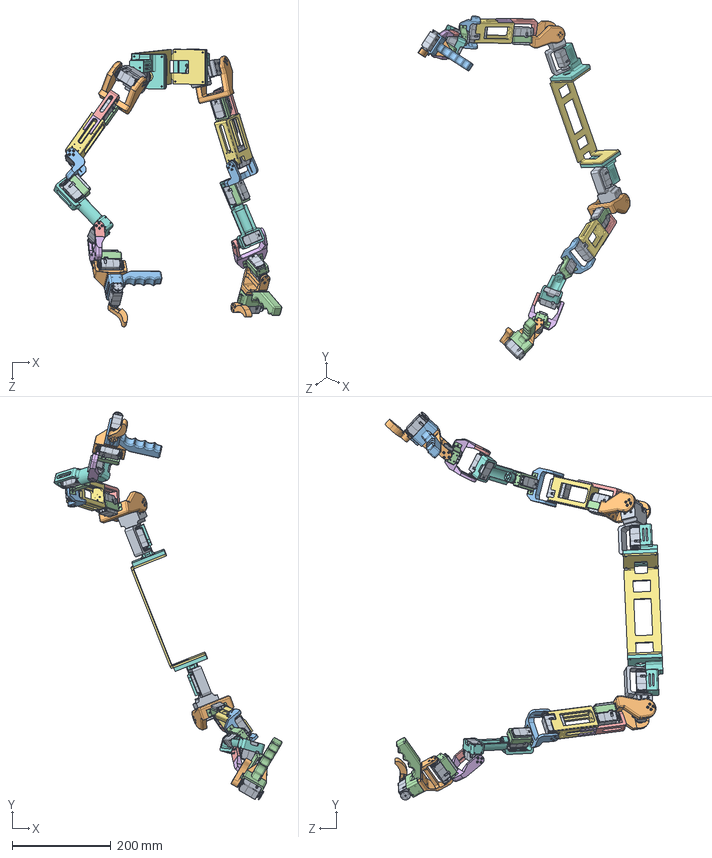
[picture p63: CAD file, 2026-03-25]
mechanical/Zhonglin_servo/dual_arm/frank_teleop_humanoid_bimanual.STEP
460.9 x 784.6 x 562.3 mm
臂1 x 2
Joint3_fanuc x 2
双轴3D x 16
joint4_support x 6
臂3 x 2
Base_gen x 2
link_1 x 2
trigger_short
trigger_short2
trigger_handle(openarm1)
trigger_handle(openarm1)_right
joint fixshort x 2
11-23_middle_bridge
Link3_new x 2
trigger_handle(openarm4.1)_new x 2
