CloudEngineHub/LeRobot-Anything-U-Arm/src/simulation/mani_skill/assets/robots/ability_hand/meshes/collision/FB_palm_ref_MIR.obj

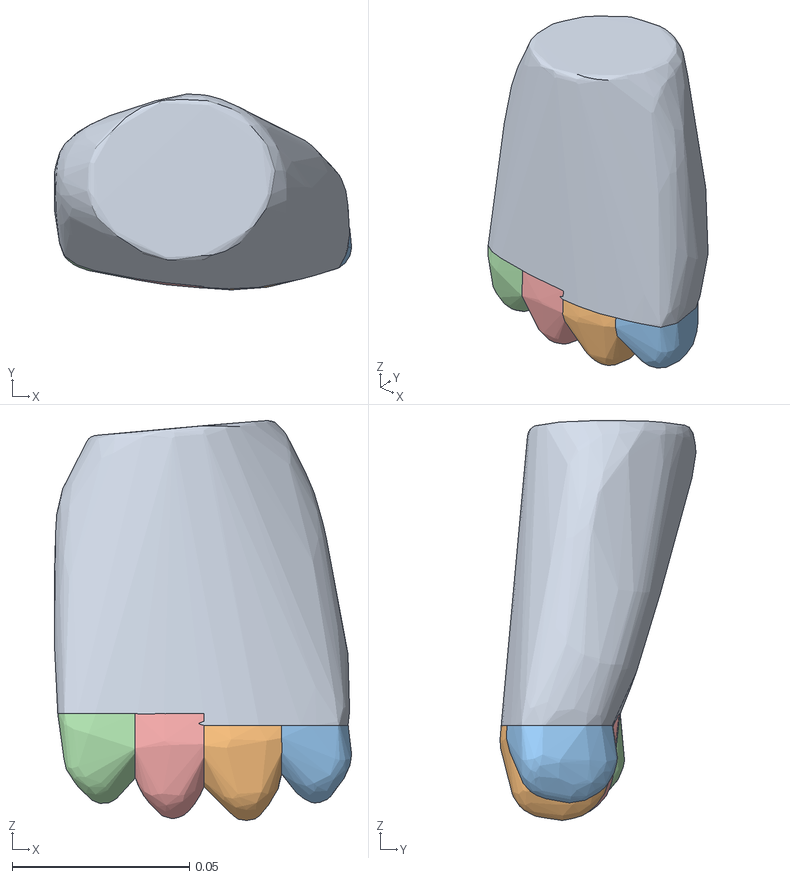
[picture p64: CAD file, 2025-08-23]
src/simulation/mani_skill/assets/robots/ability_hand/meshes/collision/FB_palm_ref_MIR.obj
0.0838 x 0.0552 x 0.113
geometry_0
geometry_1
geometry_2_geometry_2
geometry_3
geometry_4
