CloudEngineHub/LeRobot-Anything-U-Arm/src/simulation/mani_skill/assets/robots/ability_hand/meshes/visual/thumb-F1.obj

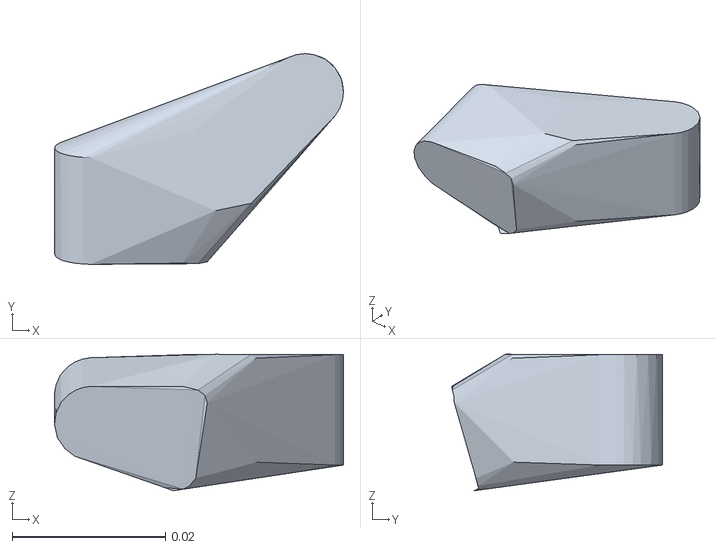
[picture p65: CAD file, 2025-08-23]
src/simulation/mani_skill/assets/robots/ability_hand/meshes/visual/thumb-F1.obj
0.0377 x 0.0275 x 0.0178
