CloudEngineHub/LeRobot-Anything-U-Arm/src/simulation/mani_skill/assets/robots/ARX-X5/meshes/link4.STL

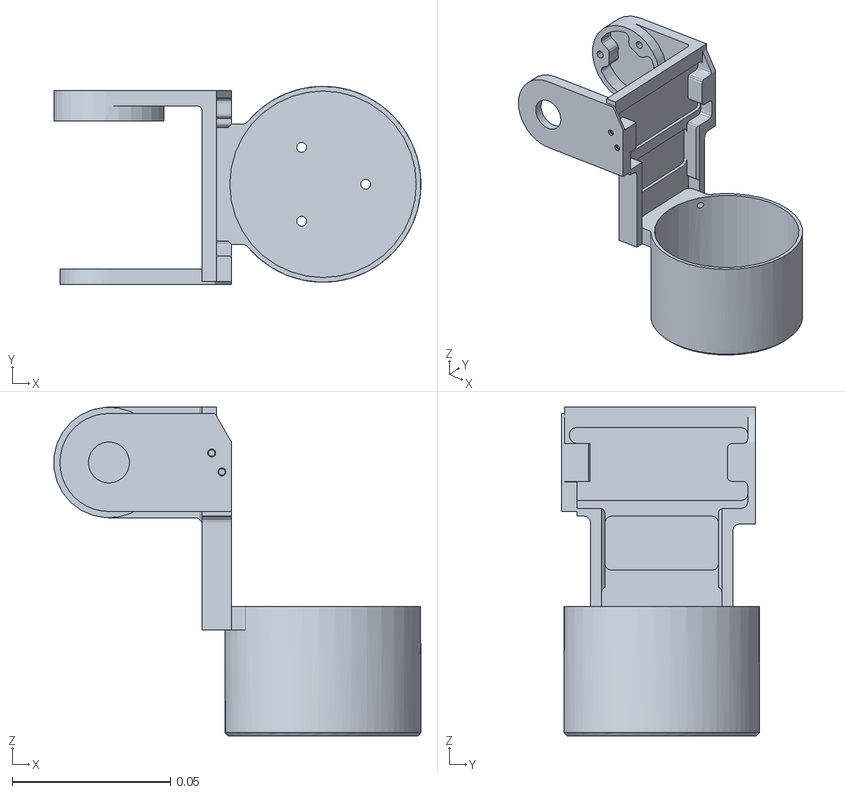
[picture p67: CAD file, 2025-08-23]
src/simulation/mani_skill/assets/robots/ARX-X5/meshes/link4.STL
0.116 x 0.0627 x 0.104
