CloudEngineHub/LeRobot-Anything-U-Arm/src/simulation/mani_skill/assets/robots/dclaw/meshes/collision/base_link_cylinder.obj

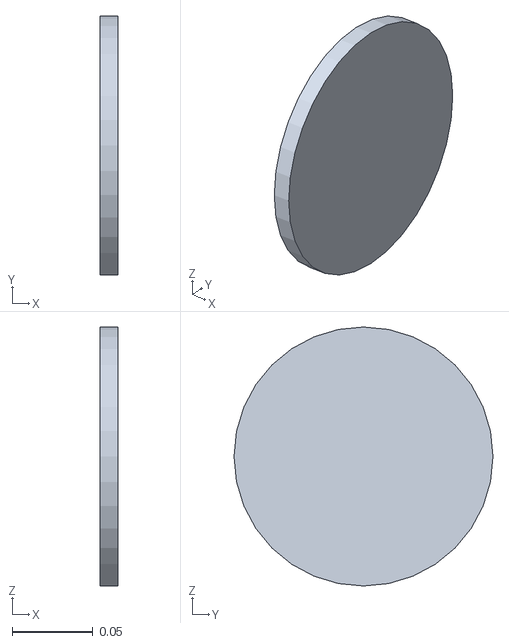
[picture p68: CAD file, 2025-08-23]
src/simulation/mani_skill/assets/robots/dclaw/meshes/collision/base_link_cylinder.obj
0.011 x 0.16 x 0.16
