CloudEngineHub/LeRobot-Anything-U-Arm/src/simulation/mani_skill/assets/robots/dclaw/meshes/visual/link_3.obj

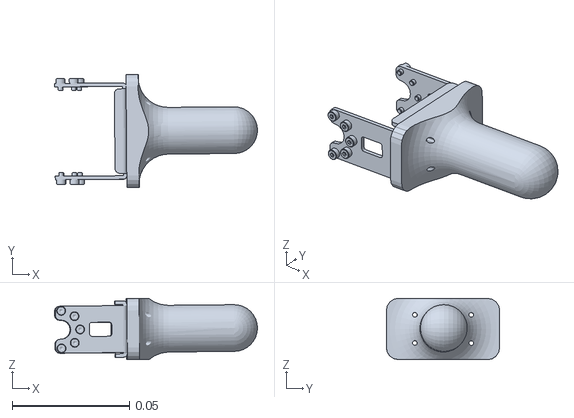
[picture p69: CAD file, 2025-08-23]
src/simulation/mani_skill/assets/robots/dclaw/meshes/visual/link_3.obj
0.0864 x 0.0482 x 0.0262
