CloudEngineHub/LeRobot-Anything-U-Arm/src/simulation/mani_skill/assets/robots/fetch/fetch_description/meshes/shoulder_pan_link_collision.STL

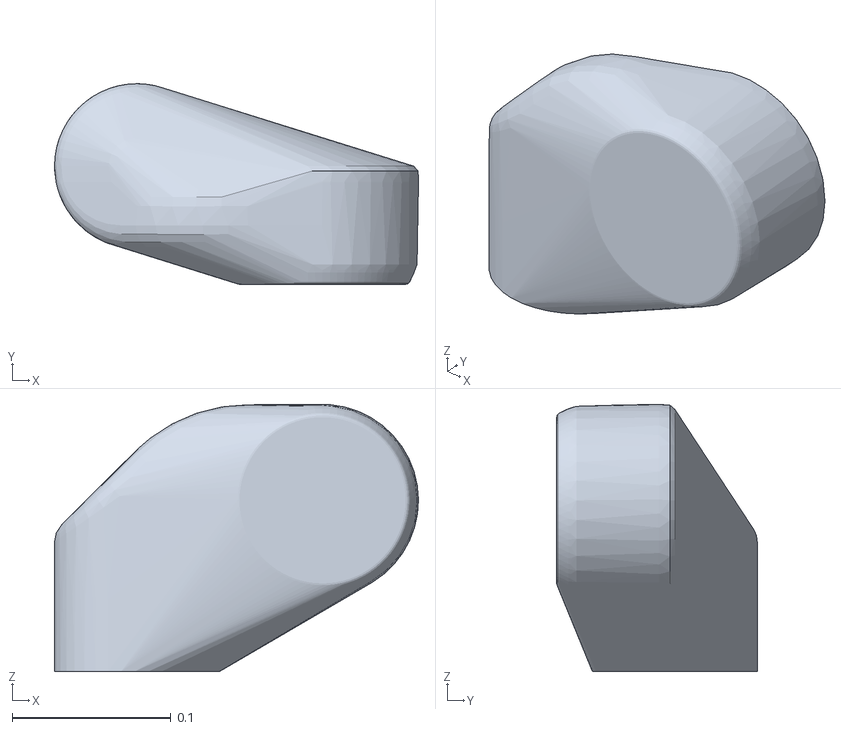
[picture p70: CAD file, 2025-08-23]
src/simulation/mani_skill/assets/robots/fetch/fetch_description/meshes/shoulder_pan_link_collision.STL
0.229 x 0.127 x 0.168
