CloudEngineHub/LeRobot-Anything-U-Arm/src/simulation/mani_skill/assets/robots/fetch_xlerobot/meshes/Lower_Arm.stl.convex.stl

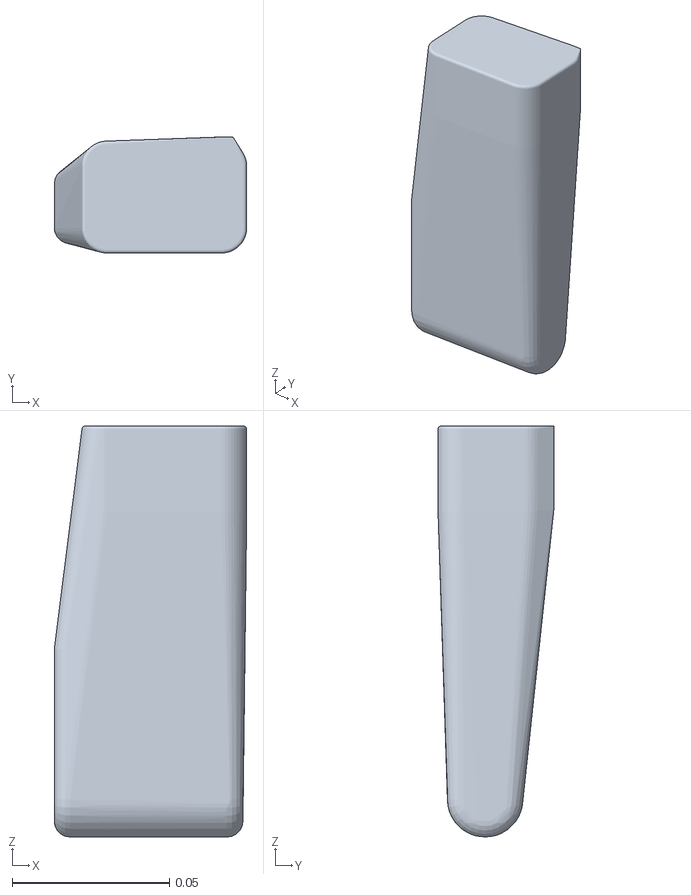
[picture p71: CAD file, 2025-08-23]
src/simulation/mani_skill/assets/robots/fetch_xlerobot/meshes/Lower_Arm.stl.convex.stl
0.0612 x 0.0369 x 0.131
