CloudEngineHub/LeRobot-Anything-U-Arm/src/simulation/mani_skill/assets/robots/koch/meshes/link_6.stl

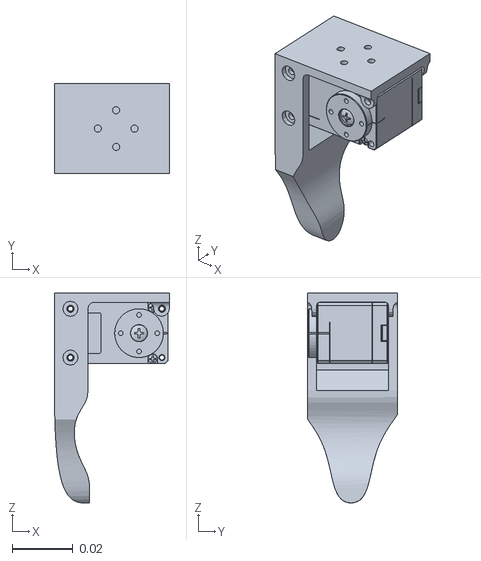
[picture p72: CAD file, 2025-08-23]
src/simulation/mani_skill/assets/robots/koch/meshes/link_6.stl
0.0378 x 0.0295 x 0.0689
