CloudEngineHub/LeRobot-Anything-U-Arm/src/simulation/mani_skill/assets/robots/panda/franka_description/meshes/collision/link0.stl.convex.stl

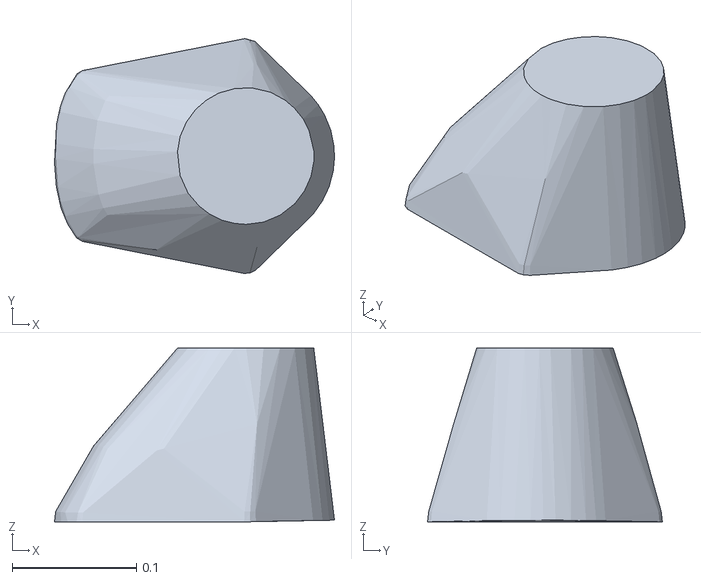
[picture p73: CAD file, 2025-08-23]
src/simulation/mani_skill/assets/robots/panda/franka_description/meshes/collision/link0.stl.convex.stl
0.226 x 0.189 x 0.14
