CloudEngineHub/LeRobot-Anything-U-Arm/src/simulation/mani_skill/assets/robots/piper/meshes/link6_1.STL

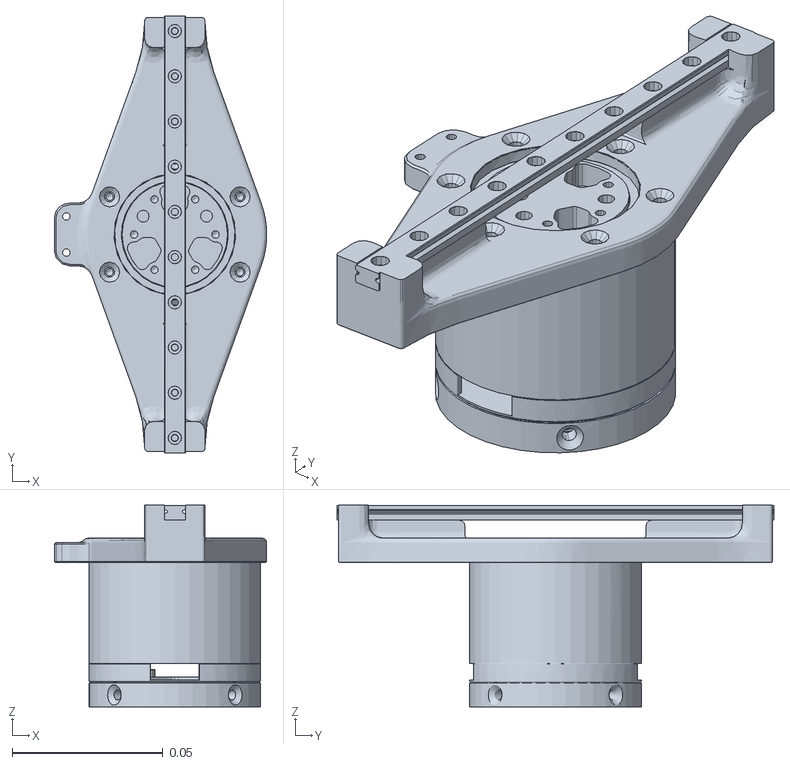
[picture p76: CAD file, 2025-08-23]
src/simulation/mani_skill/assets/robots/piper/meshes/link6_1.STL
0.0705 x 0.145 x 0.067
