CloudEngineHub/LeRobot-Anything-U-Arm/src/simulation/mani_skill/assets/robots/so100/meshes/Fixed_Jaw_Motor.stl

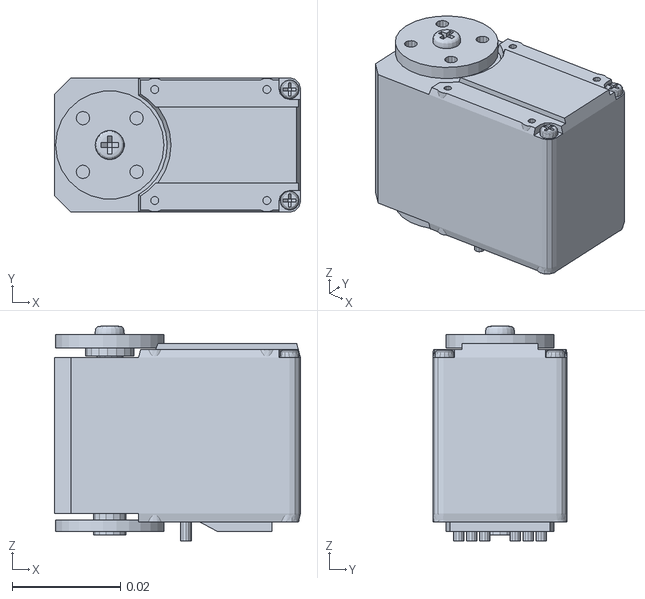
[picture p77: CAD file, 2025-08-23]
src/simulation/mani_skill/assets/robots/so100/meshes/Fixed_Jaw_Motor.stl
0.0454 x 0.0248 x 0.0396
