CloudEngineHub/LeRobot-Anything-U-Arm/src/simulation/mani_skill/assets/robots/trifinger/objects/meshes/cube_multicolor.obj

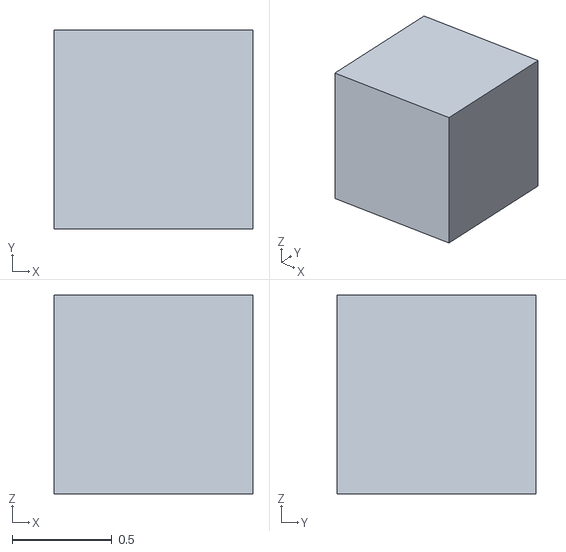
[picture p78: CAD file, 2025-08-23]
src/simulation/mani_skill/assets/robots/trifinger/objects/meshes/cube_multicolor.obj
1.00 x 1.00 x 1.00
