CloudEngineHub/LeRobot-Anything-U-Arm/src/simulation/mani_skill/assets/robots/xarm7/meshes/collision/link7.obj

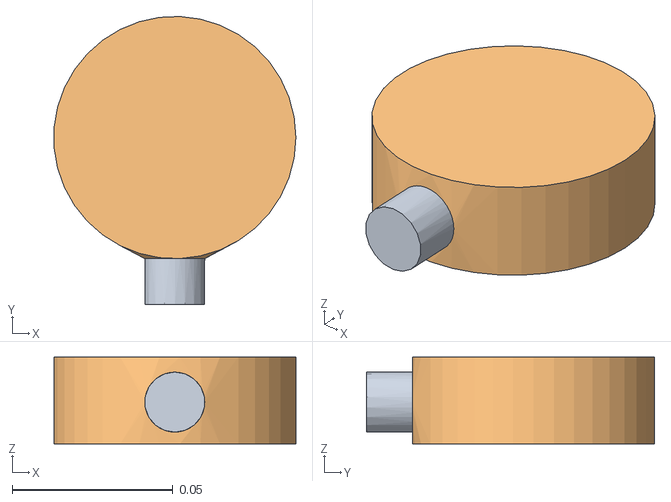
[picture p83: CAD file, 2025-08-23]
src/simulation/mani_skill/assets/robots/xarm7/meshes/collision/link7.obj
0.0753 x 0.0897 x 0.027
geometry_0
geometry_1
