CloudEngineHub/LeRobot-Anything-U-Arm/src/simulation/mani_skill/envs/tasks/fmb/assets/green_bridge.ply

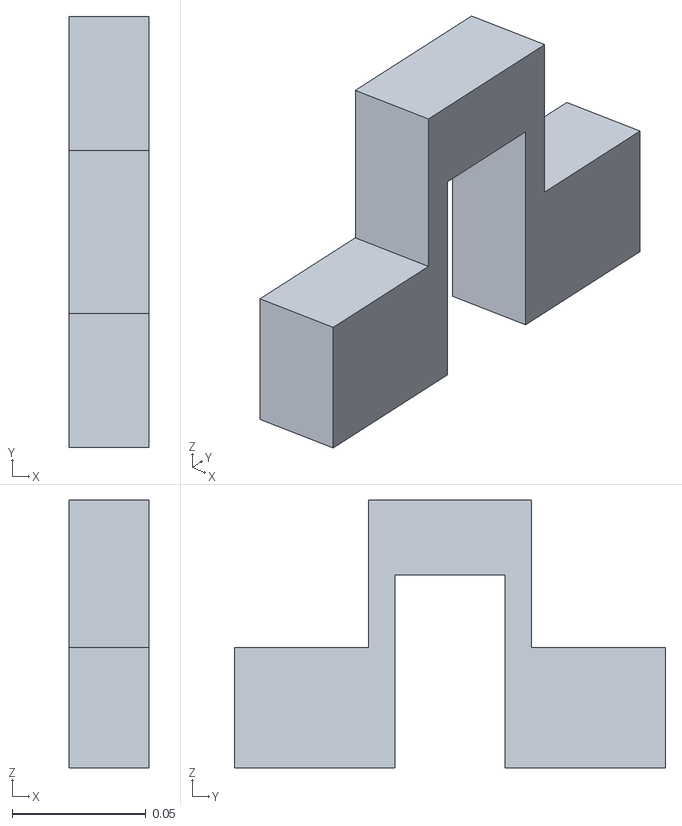
[picture p84: CAD file, 2025-08-23]
src/simulation/mani_skill/envs/tasks/fmb/assets/green_bridge.ply
0.03 x 0.161 x 0.1
