CloudEngineHub/LeRobot-Anything-U-Arm/src/simulation/mani_skill/envs/tasks/humanoid/assets/frl_apartment_bowl_07.ply

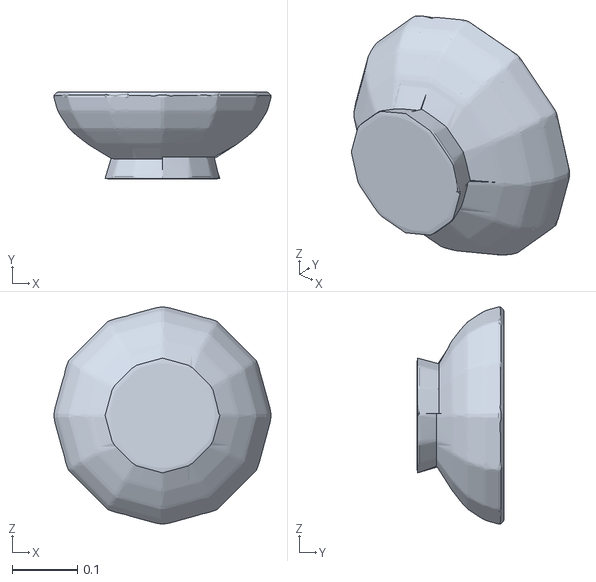
[picture p85: CAD file, 2025-08-23]
src/simulation/mani_skill/envs/tasks/humanoid/assets/frl_apartment_bowl_07.ply
0.332 x 0.134 x 0.332
