CloudEngineHub/LeRobot-Anything-U-Arm/src/simulation/mani_skill/examples/bimanual.openarm/openarm_description/assets/end_effector/parallel_link/meshes/collision/hand.stl

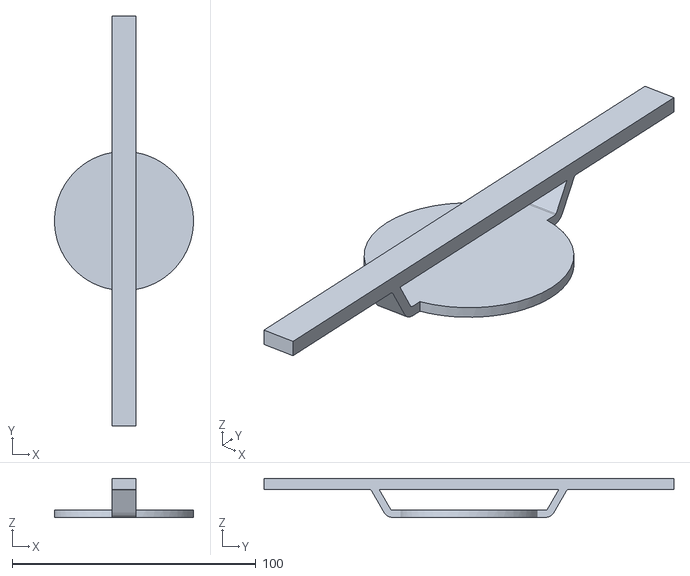
[picture p86: CAD file, 2026-07-15]
src/simulation/mani_skill/examples/bimanual.openarm/openarm_description/assets/end_effector/parallel_link/meshes/collision/hand.stl
57.0 x 168.1 x 16.0
