CloudEngineHub/LeRobot-Anything-U-Arm/src/simulation/mani_skill/examples/bimanual.openarm/openarm_description/assets/robot/openarm_v2.0/meshes/arm/collision/link5.stl

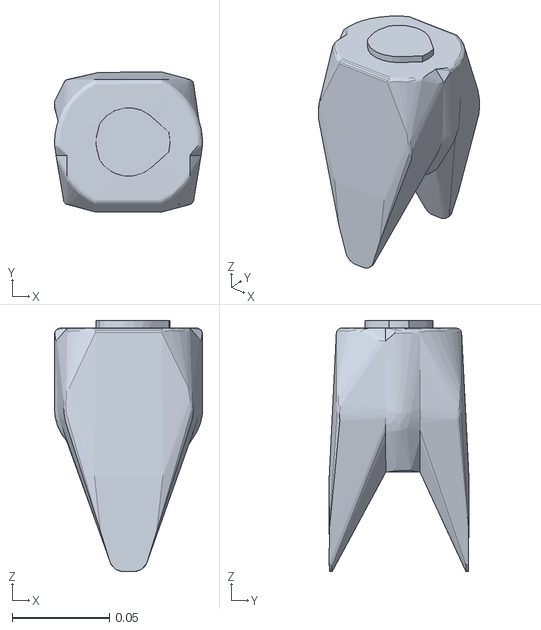
[picture p90: CAD file, 2026-07-15]
src/simulation/mani_skill/examples/bimanual.openarm/openarm_description/assets/robot/openarm_v2.0/meshes/arm/collision/link5.stl
0.076 x 0.0716 x 0.129
