CloudEngineHub/LeRobot-Anything-U-Arm/src/simulation/mani_skill/examples/bimanual.openarm/openarm_mujoco/v2/assets/collision/ee_base_link.stl

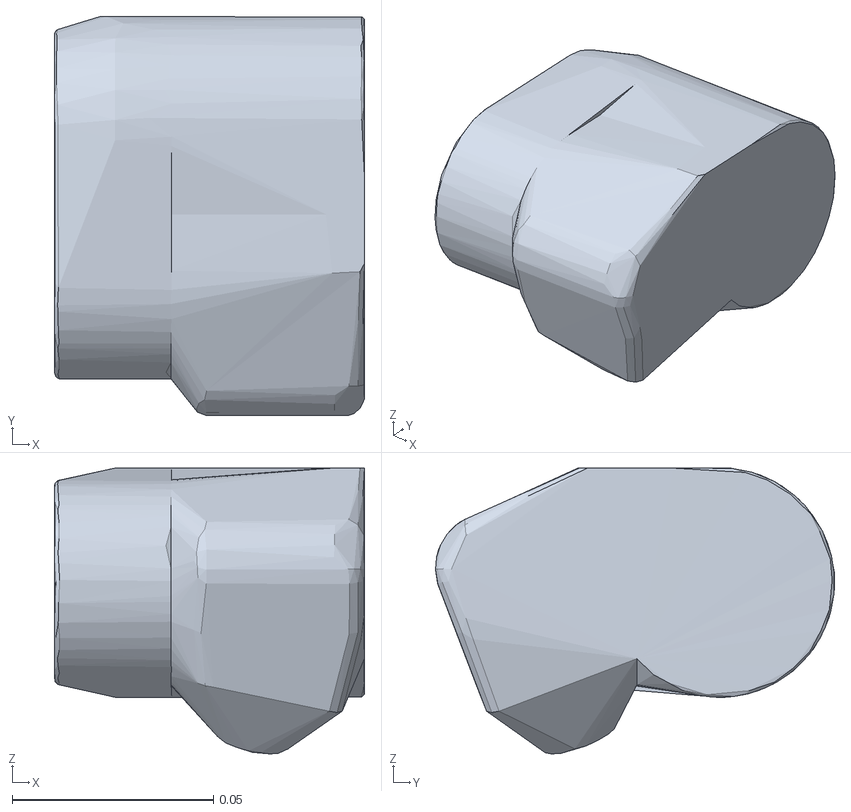
[picture p92: CAD file, 2026-07-15]
src/simulation/mani_skill/examples/bimanual.openarm/openarm_mujoco/v2/assets/collision/ee_base_link.stl
0.077 x 0.0991 x 0.071
