CloudEngineHub/LeRobot-Anything-U-Arm/src/simulation/mani_skill/examples/bimanual.openarm/openarm_mujoco/v2/assets/visual/arm/link2_01.obj

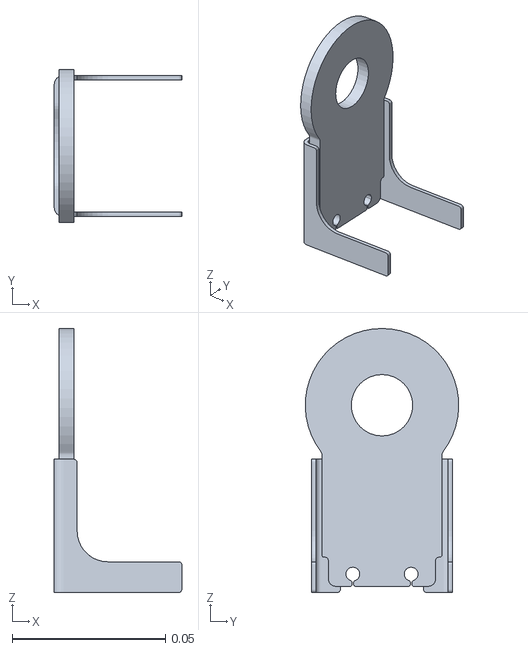
[picture p93: CAD file, 2026-07-15]
src/simulation/mani_skill/examples/bimanual.openarm/openarm_mujoco/v2/assets/visual/arm/link2_01.obj
0.0416 x 0.05 x 0.086
