CloudEngineHub/LeRobot-Anything-U-Arm/src/simulation/mani_skill/examples/bimanual.openarm/openarm_mujoco/v2/assets/visual/body/body_link0_5.obj

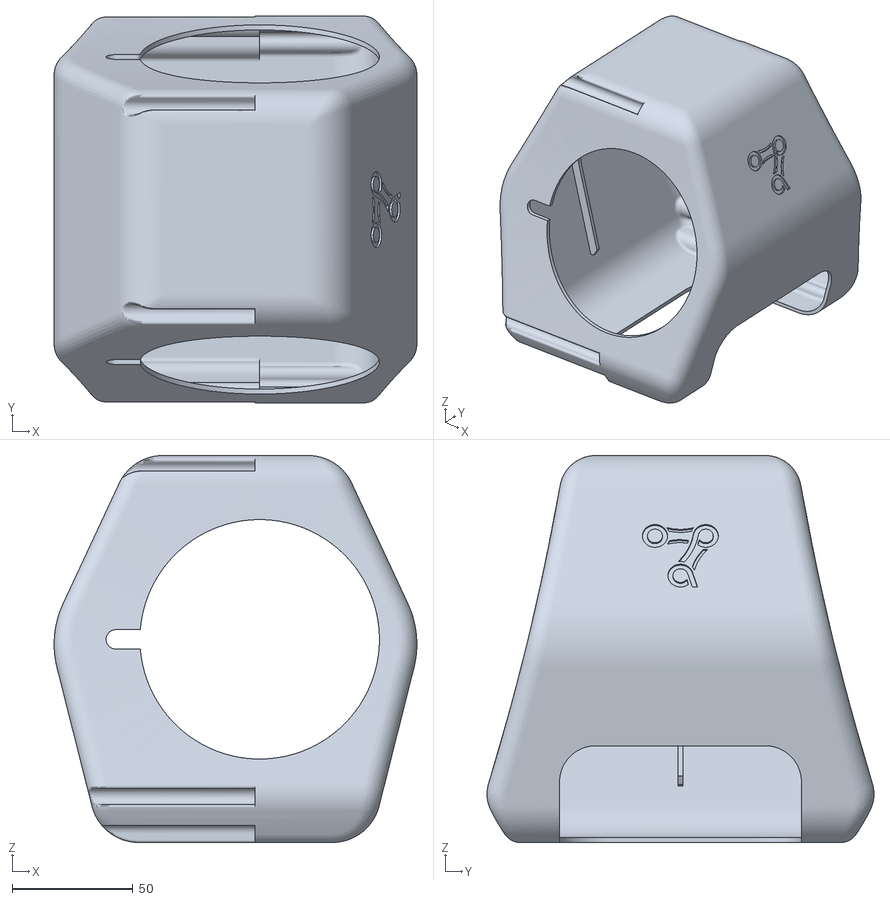
[picture p94: CAD file, 2026-07-15]
src/simulation/mani_skill/examples/bimanual.openarm/openarm_mujoco/v2/assets/visual/body/body_link0_5.obj
150.0 x 160.0 x 160.0
