CloudEngineHub/LeRobot-Anything-U-Arm/src/simulation/mani_skill/examples/bimanual.openarm/openarm_mujoco/v2/assets/visual/gripper/finger_inner_01.obj

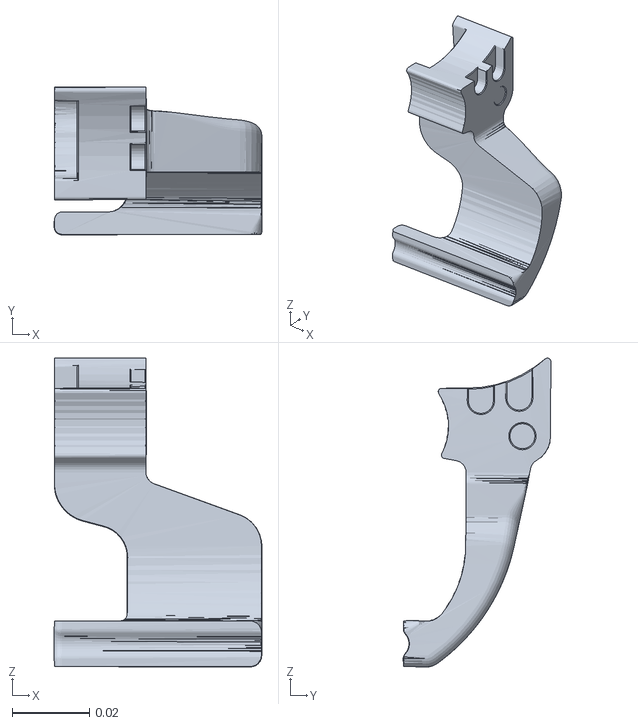
[picture p95: CAD file, 2026-07-15]
src/simulation/mani_skill/examples/bimanual.openarm/openarm_mujoco/v2/assets/visual/gripper/finger_inner_01.obj
0.054 x 0.0384 x 0.0803
