CloudEngineHub/LeRobot-Anything-U-Arm/mechanical/Zhonglin_servo/dual_arm/franka_teleop_joint4_support-1.STL

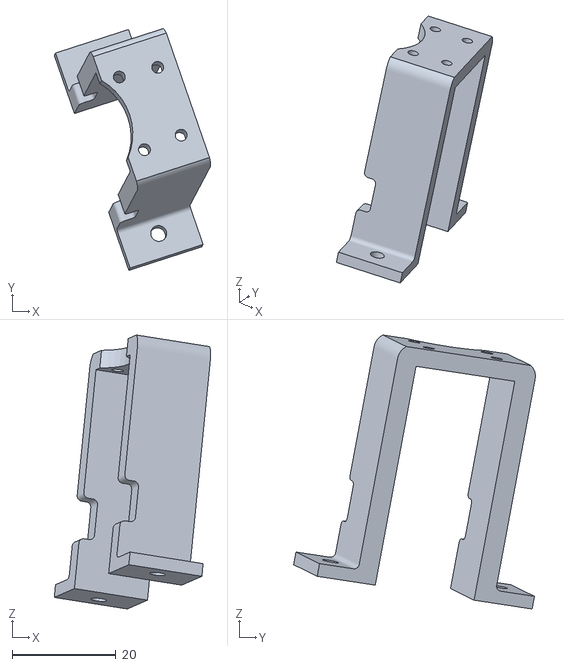
[picture p96: CAD file, 2026-03-24]
mechanical/Zhonglin_servo/dual_arm/franka_teleop_joint4_support-1.STL
30.2 x 46.7 x 52.9
