CloudEngineHub/LeRobot-Anything-U-Arm/src/simulation/mani_skill/assets/robots/ability_hand/meshes/collision/idx-F2_C.obj

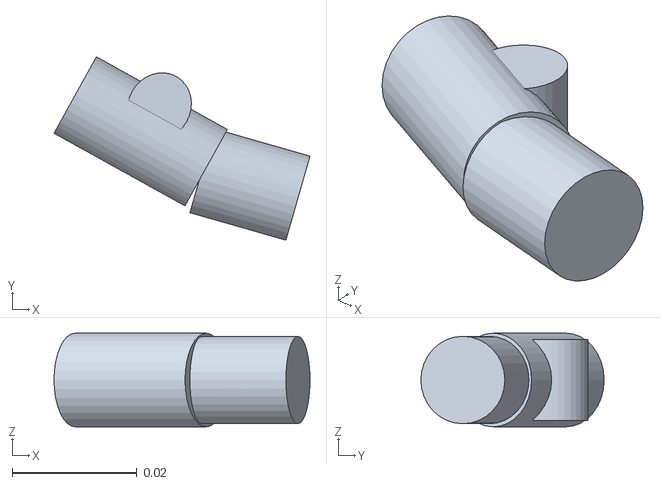
[picture p97: CAD file, 2025-08-23]
src/simulation/mani_skill/assets/robots/ability_hand/meshes/collision/idx-F2_C.obj
0.041 x 0.0294 x 0.015
