CloudEngineHub/LeRobot-Anything-U-Arm/src/simulation/mani_skill/assets/robots/allegro/meshes/visual/link_15.0.obj

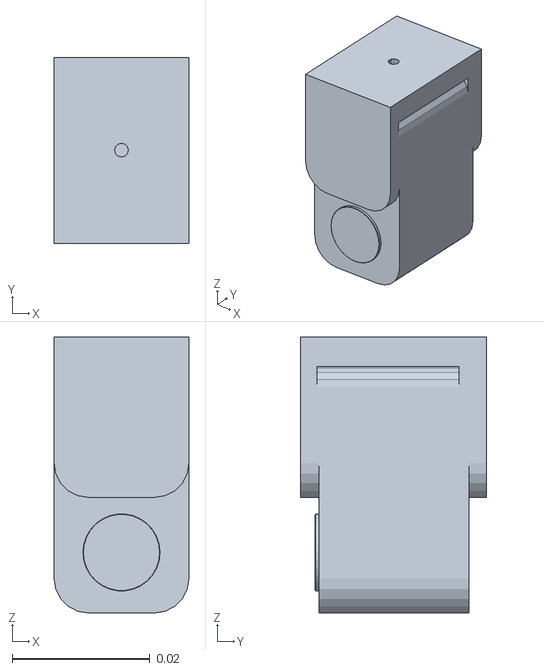
[picture p98: CAD file, 2025-08-23]
src/simulation/mani_skill/assets/robots/allegro/meshes/visual/link_15.0.obj
0.0196 x 0.027 x 0.0401
