CloudEngineHub/LeRobot-Anything-U-Arm/src/simulation/mani_skill/assets/robots/ARX-X5/meshes/base_link.STL

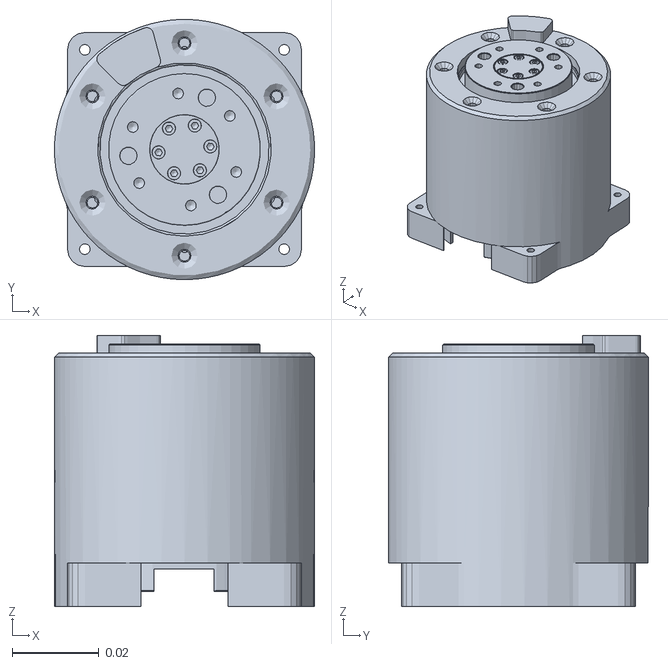
[picture p99: CAD file, 2025-08-23]
src/simulation/mani_skill/assets/robots/ARX-X5/meshes/base_link.STL
0.0599 x 0.06 x 0.0625
