CloudEngineHub/LeRobot-Anything-U-Arm/src/simulation/mani_skill/assets/robots/dclaw/meshes/visual/link_2.obj

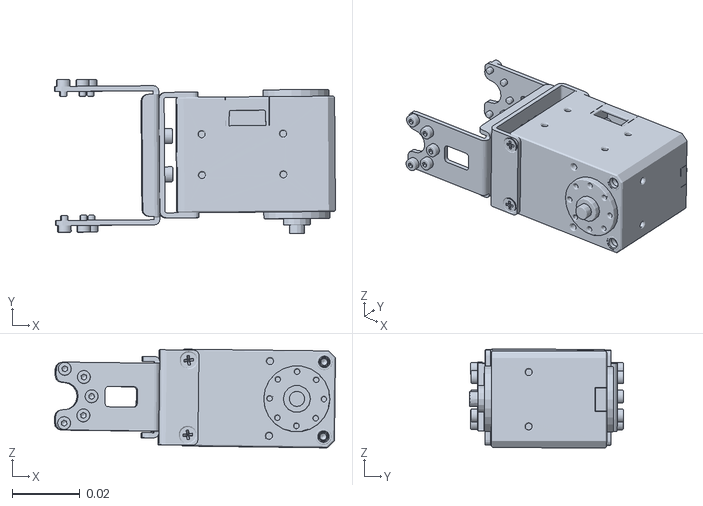
[picture p100: CAD file, 2025-08-23]
src/simulation/mani_skill/assets/robots/dclaw/meshes/visual/link_2.obj
0.0828 x 0.0454 x 0.0291
