CloudEngineHub/LeRobot-Anything-U-Arm/src/simulation/mani_skill/assets/robots/fetch/fetch_description/meshes/wrist_flex_link_collision.STL

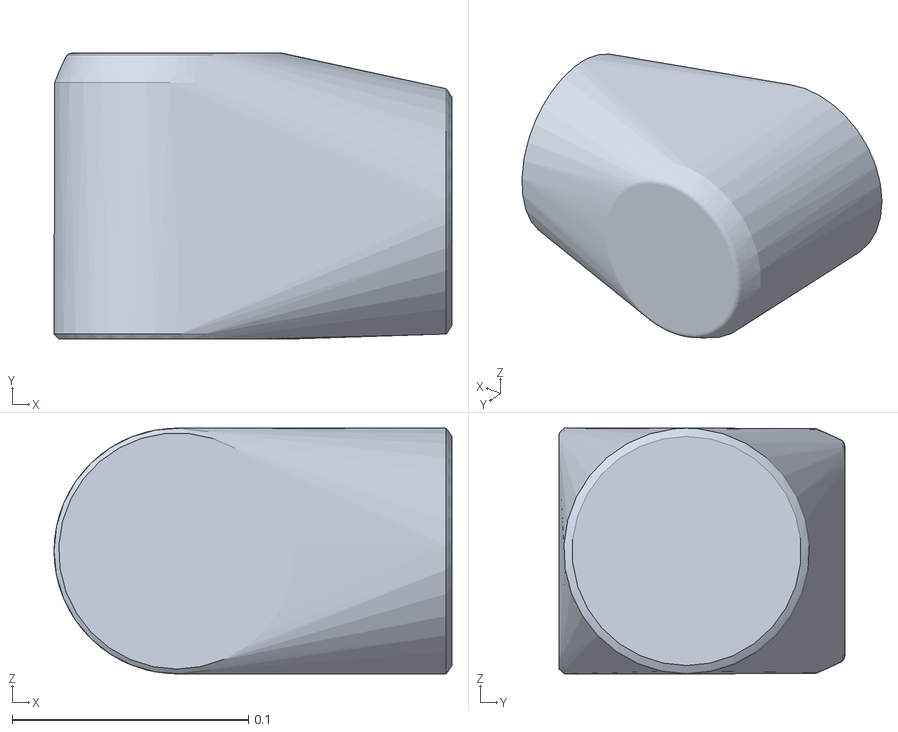
[picture p101: CAD file, 2025-08-23]
src/simulation/mani_skill/assets/robots/fetch/fetch_description/meshes/wrist_flex_link_collision.STL
0.168 x 0.121 x 0.104
