CloudEngineHub/LeRobot-Anything-U-Arm/src/simulation/mani_skill/assets/robots/fetch_xlerobot/meshes/Wrist_Pitch_Roll_Motor.stl

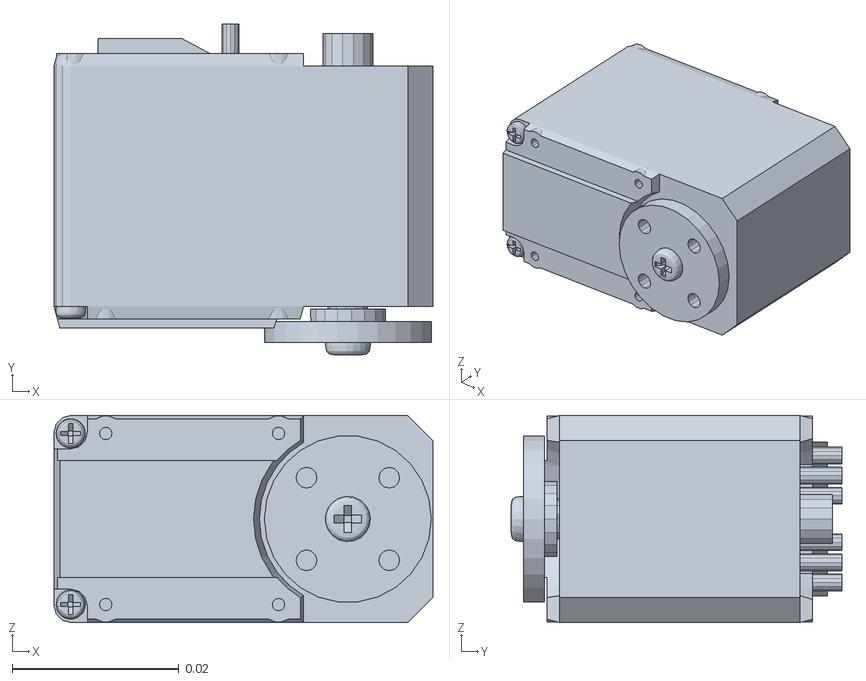
[picture p102: CAD file, 2025-08-23]
src/simulation/mani_skill/assets/robots/fetch_xlerobot/meshes/Wrist_Pitch_Roll_Motor.stl
0.0454 x 0.0396 x 0.0248
