CloudEngineHub/LeRobot-Anything-U-Arm/src/simulation/mani_skill/assets/robots/g1_humanoid/meshes/right_ankle_roll_link.STL

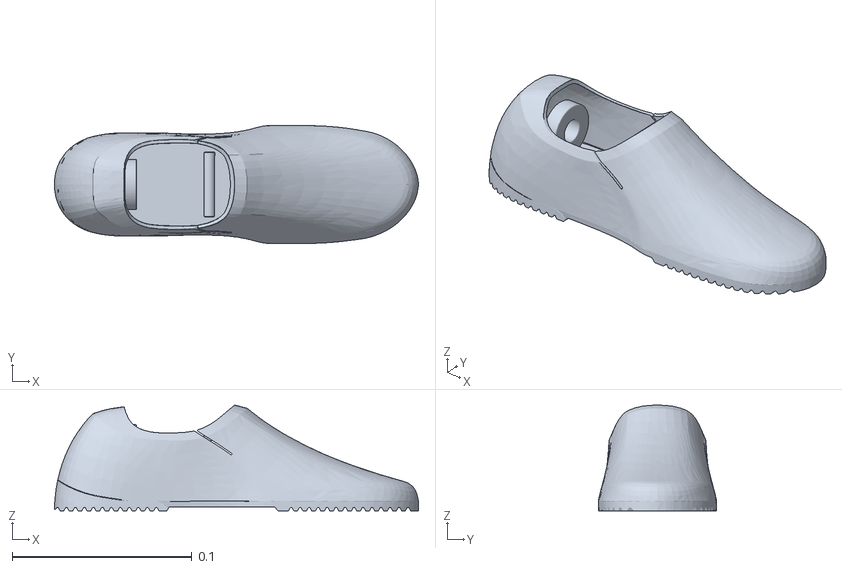
[picture p103: CAD file, 2025-08-23]
src/simulation/mani_skill/assets/robots/g1_humanoid/meshes/right_ankle_roll_link.STL
0.202 x 0.0659 x 0.0589
