CloudEngineHub/LeRobot-Anything-U-Arm/src/simulation/mani_skill/assets/robots/koch/meshes/link_1.stl

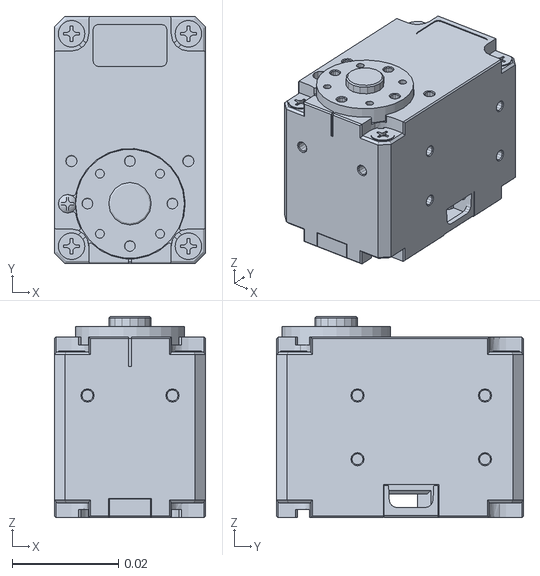
[picture p104: CAD file, 2025-08-23]
src/simulation/mani_skill/assets/robots/koch/meshes/link_1.stl
0.0285 x 0.0465 x 0.0379
