CloudEngineHub/LeRobot-Anything-U-Arm/src/simulation/mani_skill/assets/robots/panda/franka_description/meshes/collision/link4.stl

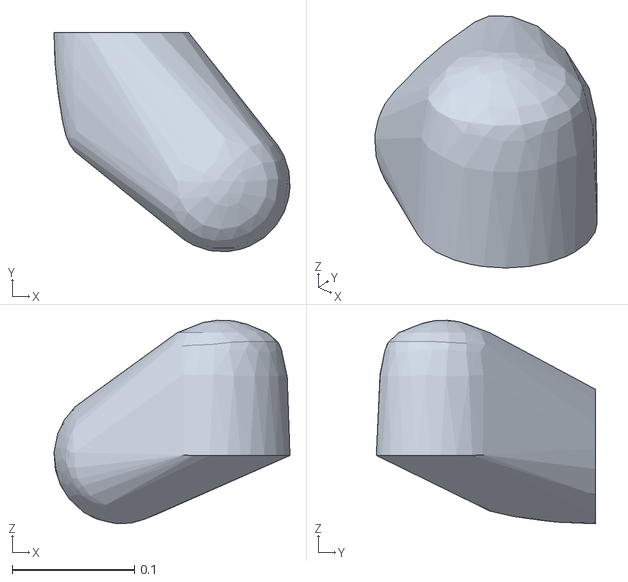
[picture p105: CAD file, 2025-08-23]
src/simulation/mani_skill/assets/robots/panda/franka_description/meshes/collision/link4.stl
0.193 x 0.179 x 0.166
