CloudEngineHub/LeRobot-Anything-U-Arm/src/simulation/mani_skill/assets/robots/piper/meshes/link7.STL

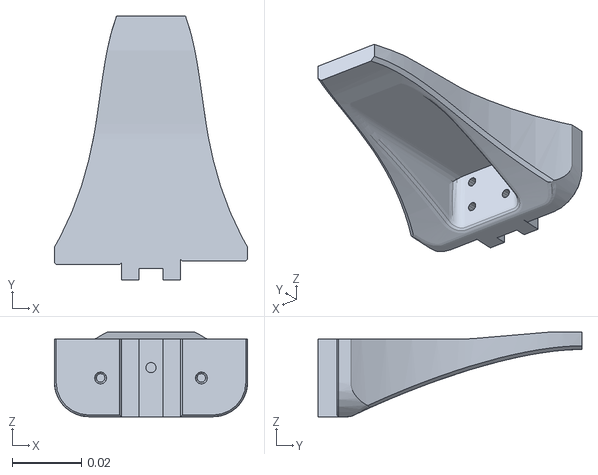
[picture p106: CAD file, 2025-08-23]
src/simulation/mani_skill/assets/robots/piper/meshes/link7.STL
0.056 x 0.0765 x 0.0245
