CloudEngineHub/LeRobot-Anything-U-Arm/src/simulation/mani_skill/assets/robots/so100/meshes/Moving_Jaw.stl.convex.stl

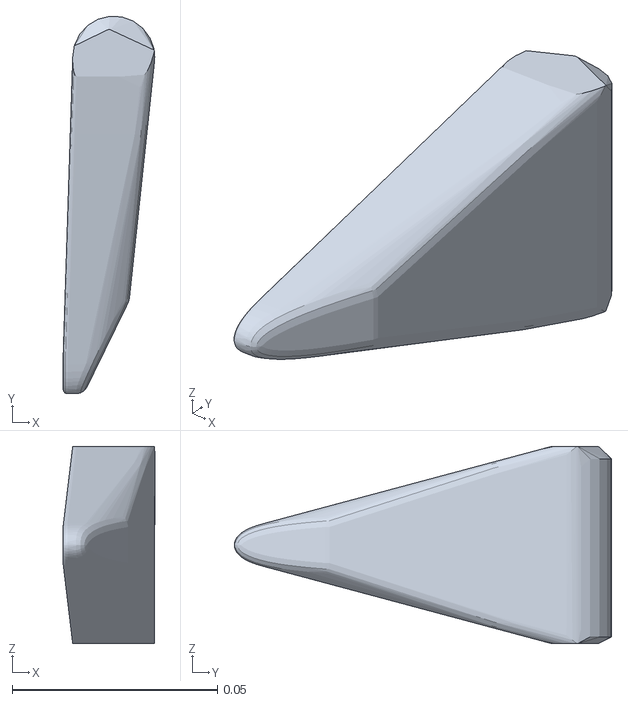
[picture p107: CAD file, 2025-08-23]
src/simulation/mani_skill/assets/robots/so100/meshes/Moving_Jaw.stl.convex.stl
0.0223 x 0.092 x 0.048
