CloudEngineHub/LeRobot-Anything-U-Arm/src/simulation/mani_skill/examples/bimanual.openarm/openarm_mujoco/v2/assets/visual/gripper/ee_base_link_02.obj

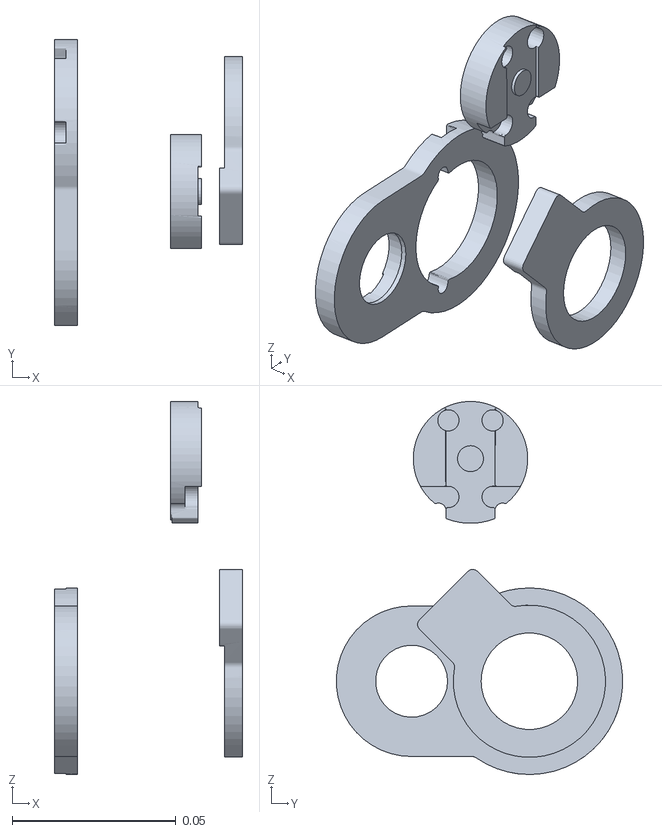
[picture p117: CAD file, 2026-07-15]
src/simulation/mani_skill/examples/bimanual.openarm/openarm_mujoco/v2/assets/visual/gripper/ee_base_link_02.obj
0.0575 x 0.0874 x 0.114
