CloudEngineHub/LeRobot-Anything-U-Arm/mechanical/Zhonglin_servo/dual_arm/franka_teleop_trigger_handle_right-1.STL

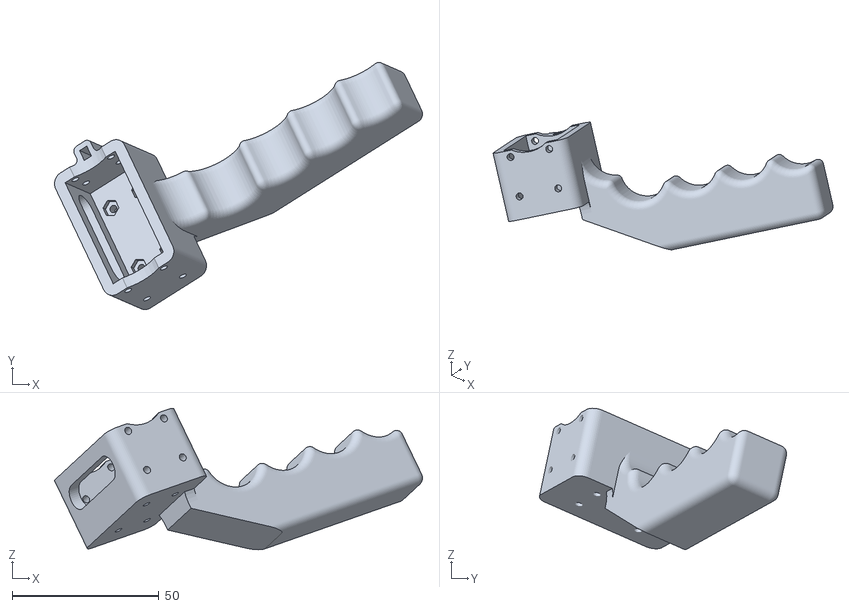
[picture p118: CAD file, 2026-03-24]
mechanical/Zhonglin_servo/dual_arm/franka_teleop_trigger_handle_right-1.STL
125.3 x 84.1 x 48.2
