CloudEngineHub/LeRobot-Anything-U-Arm/src/simulation/mani_skill/assets/robots/ARX-X5/meshes/link8.STL

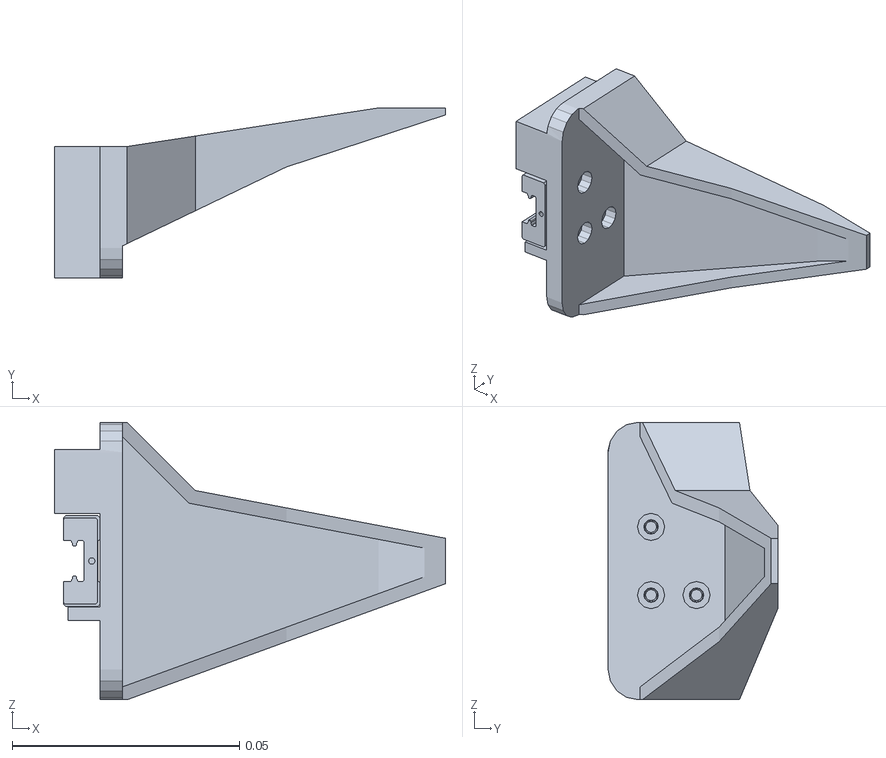
[picture p119: CAD file, 2025-08-23]
src/simulation/mani_skill/assets/robots/ARX-X5/meshes/link8.STL
0.086 x 0.0373 x 0.061
