CloudEngineHub/LeRobot-Anything-U-Arm/src/simulation/mani_skill/assets/robots/dclaw/meshes/visual/base_link.obj

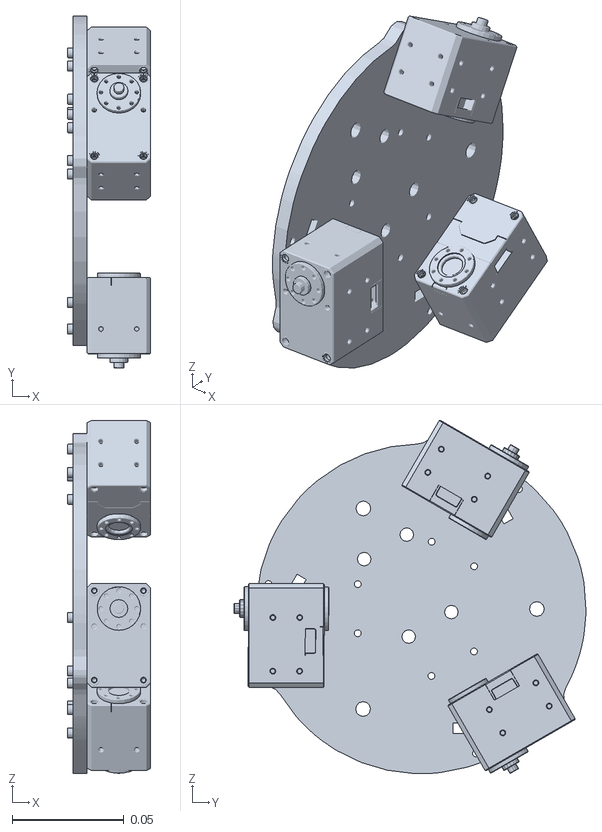
[picture p120: CAD file, 2025-08-23]
src/simulation/mani_skill/assets/robots/dclaw/meshes/visual/base_link.obj
0.0374 x 0.158 x 0.158
