CloudEngineHub/LeRobot-Anything-U-Arm/src/simulation/mani_skill/assets/robots/fetch/fetch_description/meshes/forearm_roll_link_collision.STL

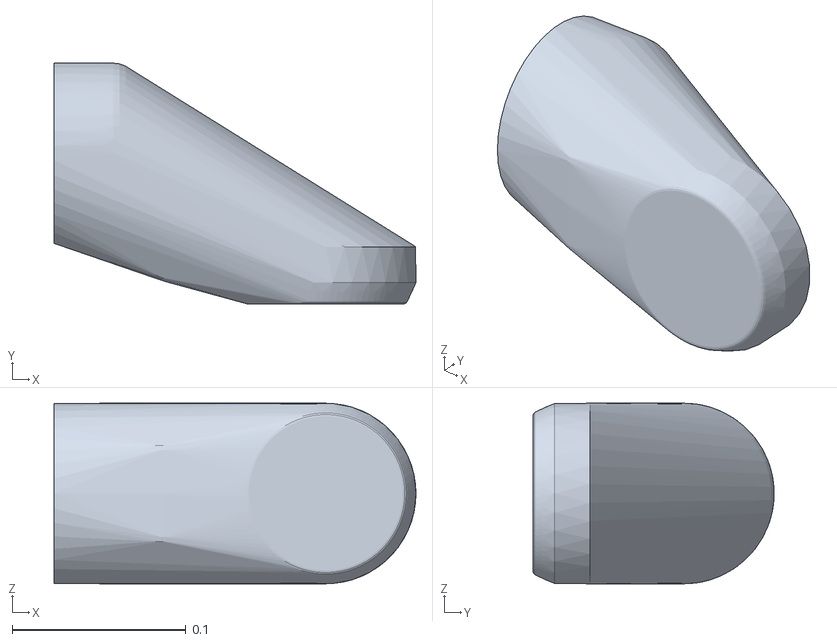
[picture p121: CAD file, 2025-08-23]
src/simulation/mani_skill/assets/robots/fetch/fetch_description/meshes/forearm_roll_link_collision.STL
0.208 x 0.139 x 0.104
