CloudEngineHub/LeRobot-Anything-U-Arm/src/simulation/mani_skill/assets/robots/fetch_xlerobot/meshes/Upper_Arm.stl

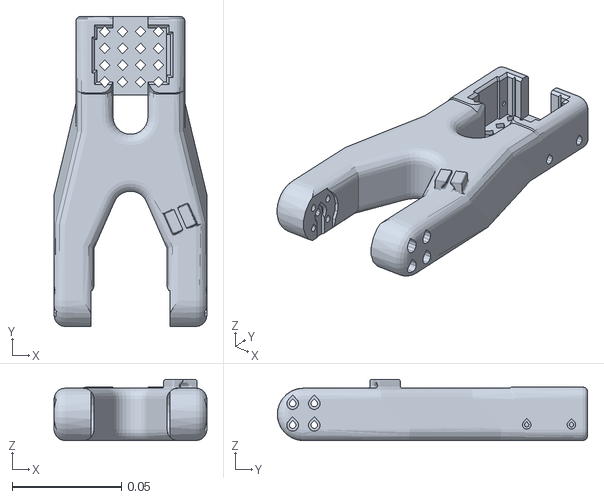
[picture p122: CAD file, 2025-08-23]
src/simulation/mani_skill/assets/robots/fetch_xlerobot/meshes/Upper_Arm.stl
0.07 x 0.142 x 0.028
