CloudEngineHub/LeRobot-Anything-U-Arm/src/simulation/mani_skill/assets/robots/g1_humanoid/meshes/left_shoulder_roll_link.STL

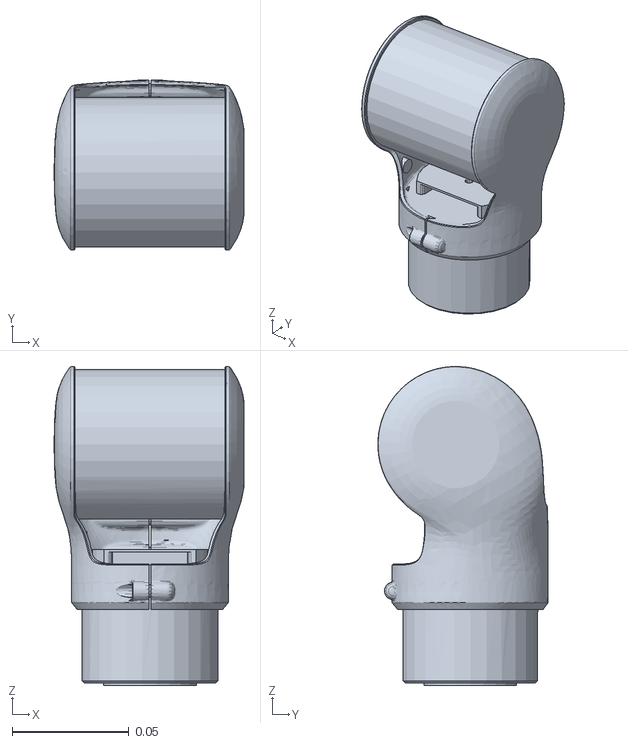
[picture p123: CAD file, 2025-08-23]
src/simulation/mani_skill/assets/robots/g1_humanoid/meshes/left_shoulder_roll_link.STL
0.0812 x 0.0729 x 0.137
