CloudEngineHub/LeRobot-Anything-U-Arm/src/simulation/mani_skill/assets/robots/koch/meshes/base_link.stl

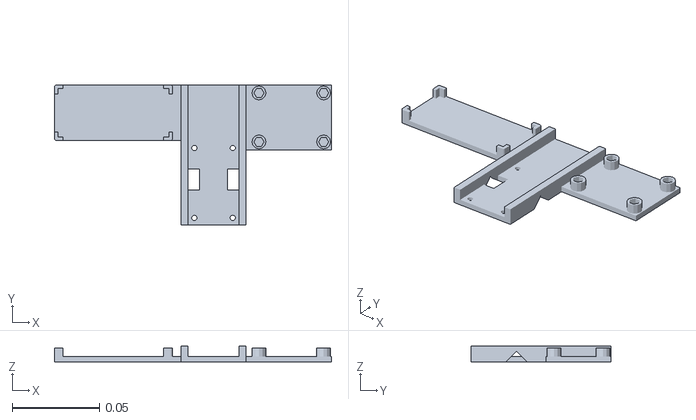
[picture p124: CAD file, 2025-08-23]
src/simulation/mani_skill/assets/robots/koch/meshes/base_link.stl
0.159 x 0.08 x 0.009
