CloudEngineHub/LeRobot-Anything-U-Arm/src/simulation/mani_skill/assets/robots/panda/franka_description/meshes/collision/link3.stl

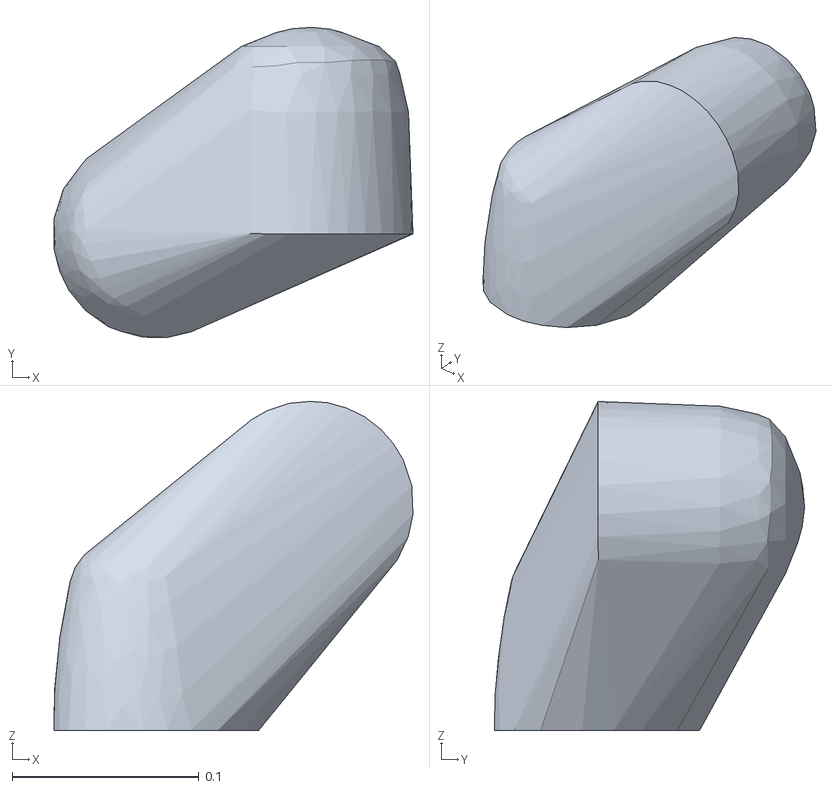
[picture p125: CAD file, 2025-08-23]
src/simulation/mani_skill/assets/robots/panda/franka_description/meshes/collision/link3.stl
0.192 x 0.166 x 0.176
