CloudEngineHub/LeRobot-Anything-U-Arm/src/simulation/mani_skill/assets/robots/piper/meshes/link3.STL

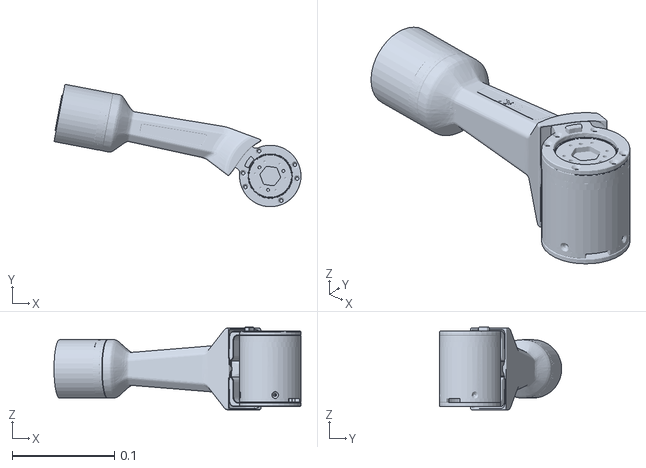
[picture p126: CAD file, 2025-08-23]
src/simulation/mani_skill/assets/robots/piper/meshes/link3.STL
0.241 x 0.12 x 0.0807
