CloudEngineHub/LeRobot-Anything-U-Arm/src/simulation/mani_skill/assets/robots/trifinger/robot_properties_fingers/meshes/SIM__BL-Finger_Base.stl

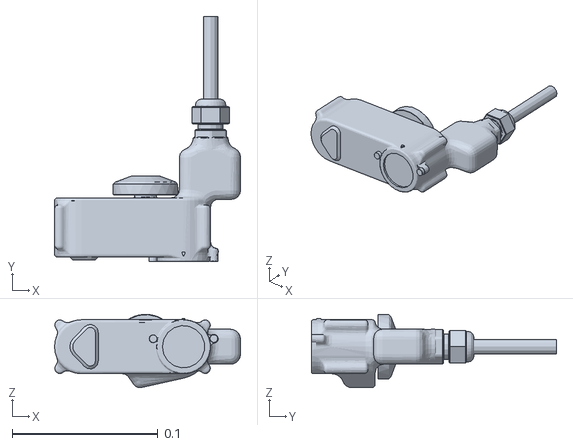
[picture p130: CAD file, 2025-08-23]
src/simulation/mani_skill/assets/robots/trifinger/robot_properties_fingers/meshes/SIM__BL-Finger_Base.stl
0.127 x 0.168 x 0.0501
