CloudEngineHub/LeRobot-Anything-U-Arm/src/simulation/mani_skill/examples/bimanual.openarm/openarm_mujoco/v2/assets/visual/gripper/finger_inner_00.obj

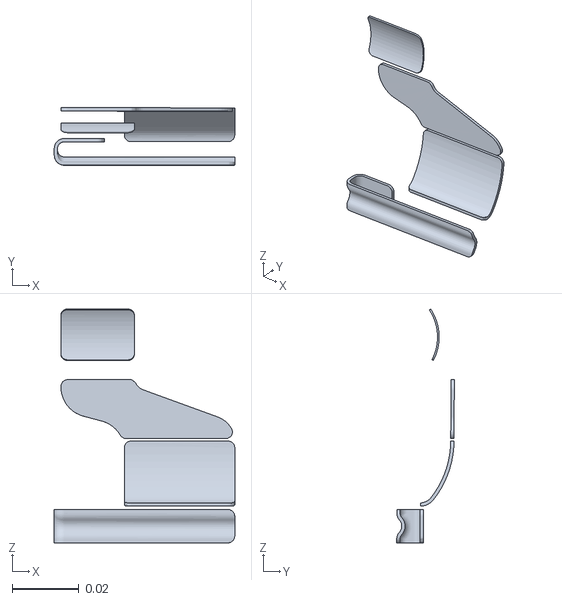
[picture p134: CAD file, 2026-07-15]
src/simulation/mani_skill/examples/bimanual.openarm/openarm_mujoco/v2/assets/visual/gripper/finger_inner_00.obj
0.054 x 0.0172 x 0.0699
