CloudEngineHub/LeRobot-Anything-U-Arm/mechanical/Zhonglin_servo/dual_arm/franka_teleop_trigger_short2-4.STL

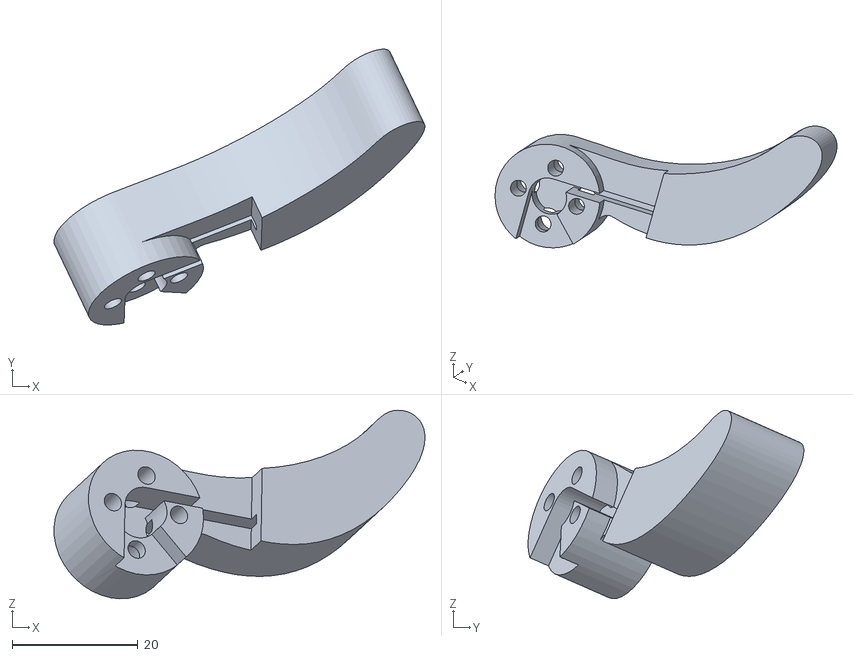
[picture p135: CAD file, 2026-03-24]
mechanical/Zhonglin_servo/dual_arm/franka_teleop_trigger_short2-4.STL
59.1 x 43.9 x 30.0
