CloudEngineHub/LeRobot-Anything-U-Arm/src/simulation/mani_skill/assets/robots/ability_hand/meshes/visual/idx-F2.obj

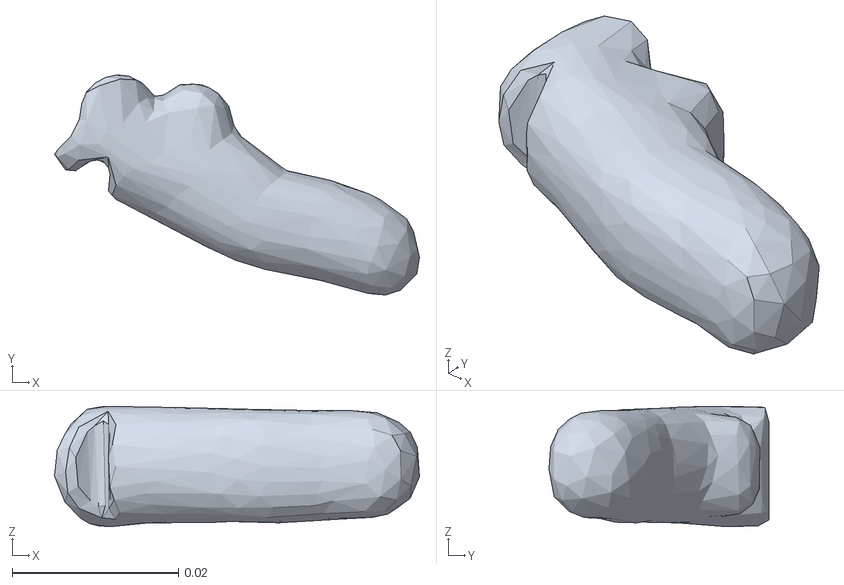
[picture p136: CAD file, 2025-08-23]
src/simulation/mani_skill/assets/robots/ability_hand/meshes/visual/idx-F2.obj
0.0439 x 0.0265 x 0.0145
