CloudEngineHub/LeRobot-Anything-U-Arm/src/simulation/mani_skill/assets/robots/ARX-X5/meshes/camera_base.STL

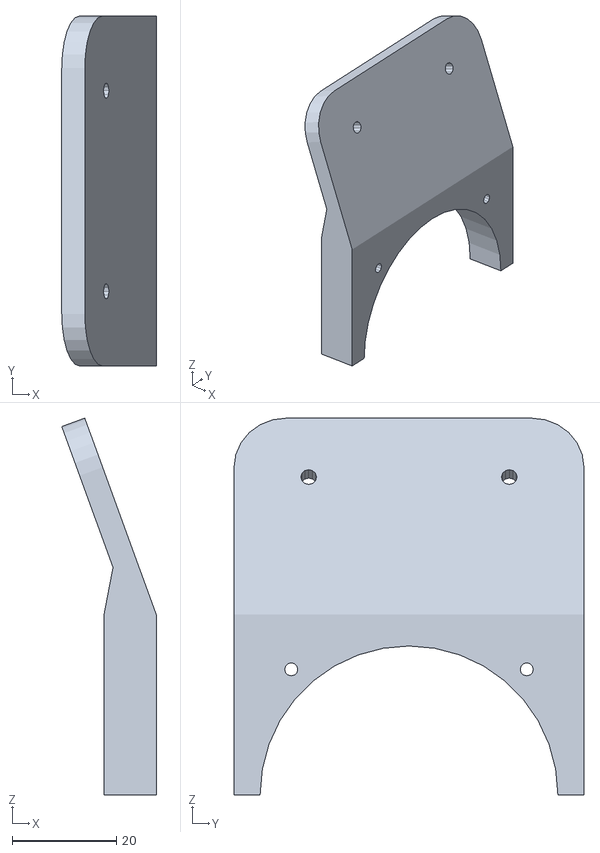
[picture p137: CAD file, 2025-08-23]
src/simulation/mani_skill/assets/robots/ARX-X5/meshes/camera_base.STL
18.1 x 67.0 x 72.1
