CloudEngineHub/LeRobot-Anything-U-Arm/src/simulation/mani_skill/assets/robots/fetch_xlerobot/meshes/Moving_Jaw_part1.ply

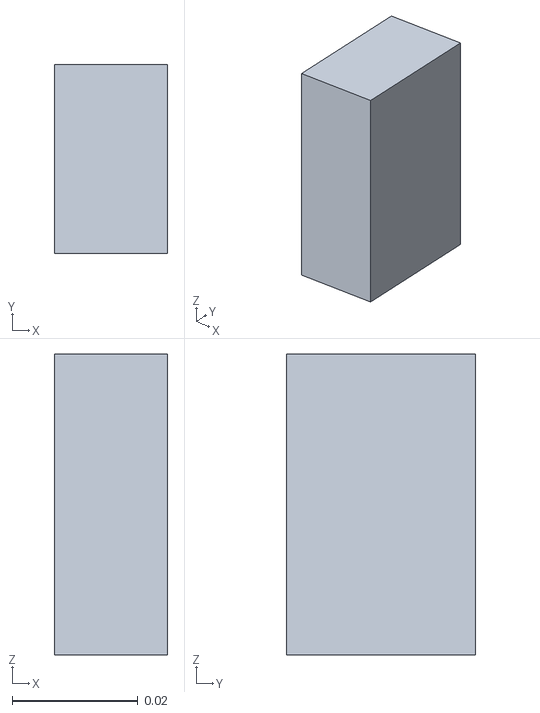
[picture p138: CAD file, 2025-08-23]
src/simulation/mani_skill/assets/robots/fetch_xlerobot/meshes/Moving_Jaw_part1.ply
0.018 x 0.03 x 0.0478
