CloudEngineHub/LeRobot-Anything-U-Arm/src/simulation/mani_skill/assets/robots/g1_humanoid/meshes/left_hip_yaw_link.STL

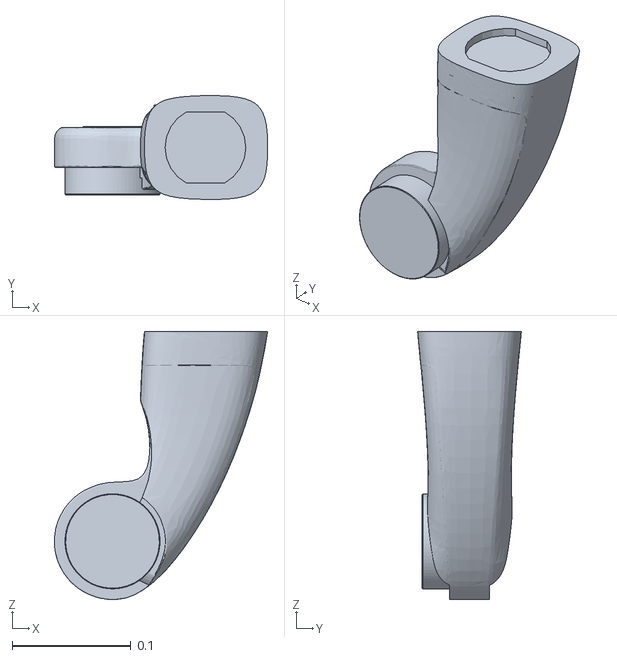
[picture p139: CAD file, 2025-08-23]
src/simulation/mani_skill/assets/robots/g1_humanoid/meshes/left_hip_yaw_link.STL
0.18 x 0.0874 x 0.226
