CloudEngineHub/LeRobot-Anything-U-Arm/src/simulation/mani_skill/assets/robots/koch/meshes/link_3_motor.stl

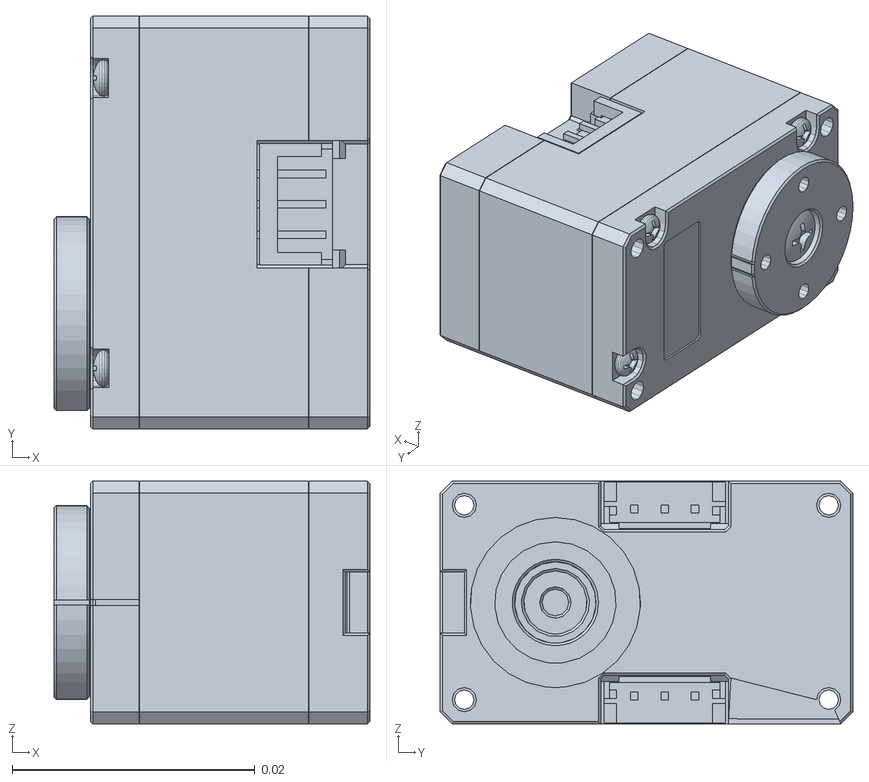
[picture p140: CAD file, 2025-08-23]
src/simulation/mani_skill/assets/robots/koch/meshes/link_3_motor.stl
0.026 x 0.034 x 0.02
