CloudEngineHub/LeRobot-Anything-U-Arm/src/simulation/mani_skill/assets/robots/panda/franka_description/meshes/collision/hand.stl.convex.stl

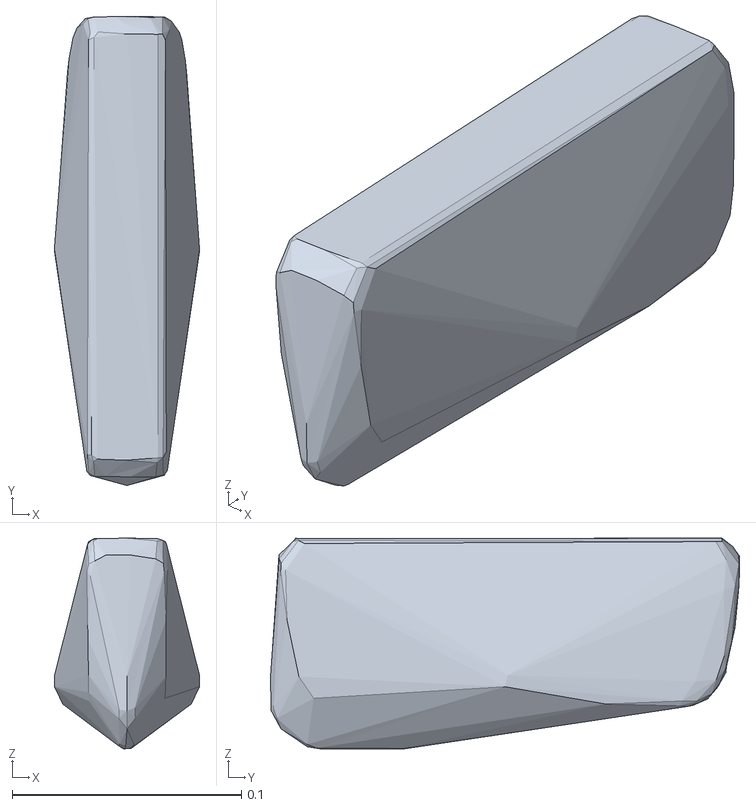
[picture p141: CAD file, 2025-08-23]
src/simulation/mani_skill/assets/robots/panda/franka_description/meshes/collision/hand.stl.convex.stl
0.0633 x 0.204 x 0.0919
