CloudEngineHub/LeRobot-Anything-U-Arm/src/simulation/mani_skill/assets/robots/piper/meshes/link5.STL

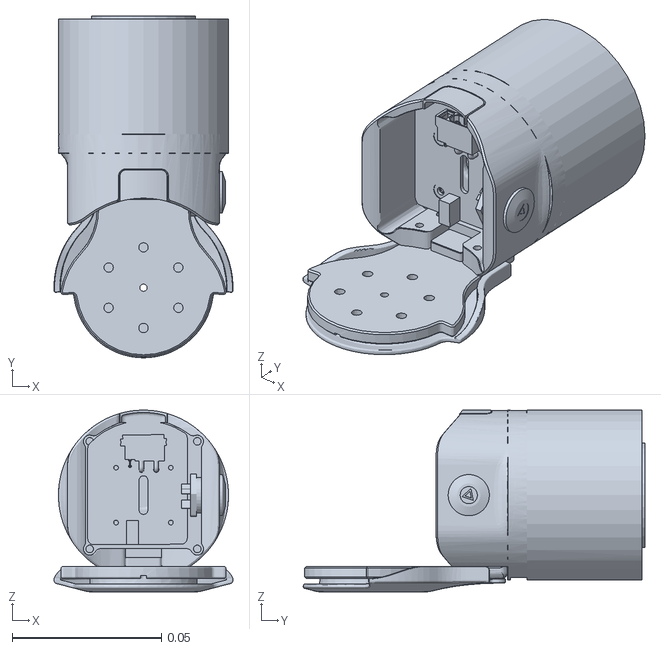
[picture p142: CAD file, 2025-08-23]
src/simulation/mani_skill/assets/robots/piper/meshes/link5.STL
0.06 x 0.115 x 0.0609
