CloudEngineHub/LeRobot-Anything-U-Arm/(list of files, cad)

Other CAD files:
src/simulation/mani_skill/assets/robots/allegro/meshes/visual/link_tip.obj
src/simulation/mani_skill/assets/robots/g1_humanoid/meshes/right_four_link.STL
src/simulation/mani_skill/examples/bimanual.openarm/openarm_description/assets/end_effector/pinch_gripper/meshes/collision/finger_inner.stl
src/simulation/mani_skill/examples/bimanual.openarm/openarm_mujoco/v2/assets/visual/cell/cover.obj
src/simulation/mani_skill/assets/robots/ability_hand/meshes/visual/FB_palm_ref.obj
src/simulation/mani_skill/envs/tasks/humanoid/assets/test.obj
src/simulation/mani_skill/examples/bimanual.openarm/openarm_description/assets/end_effector/pinch_gripper/meshes/collision/splited/finger_inner/finger_inner_00.stl
src/simulation/mani_skill/examples/bimanual.openarm/openarm_description/assets/end_effector/pinch_gripper/meshes/collision/splited/finger_outer/finger_outer_02.stl
src/simulation/mani_skill/assets/robots/ability_hand/meshes/collision/FB_palm_ref.obj
src/simulation/mani_skill/assets/robots/ability_hand/meshes/visual/thumb-F1-MIR.obj
src/simulation/mani_skill/assets/robots/allegro/meshes/visual/link_4.0.obj
src/simulation/mani_skill/examples/bimanual.openarm/openarm_description/assets/end_effector/pinch_gripper/meshes/collision/splited/finger_inner/finger_inner_03.stl
src/simulation/mani_skill/assets/robots/ability_hand/meshes/collision/thumb-F1-MIR_C.obj
src/simulation/mani_skill/assets/robots/allegro/meshes/visual/link_0.0.obj
src/simulation/mani_skill/assets/robots/fetch/fetch_description/meshes/r_gripper_finger_link.STL
src/simulation/mani_skill/assets/robots/so100/meshes/Rotation_Pitch_Motor.stl
mechanical/Zhonglin_servo/dual_arm/franka_teleop _Base_gen-1.STL
mechanical/Zhonglin_servo/dual_arm/franka_teleop_ Link3_new-2.STL
mechanical/Zhonglin_servo/dual_arm/franka_teleop_Base_gen-3.STL
mechanical/Zhonglin_servo/dual_arm/franka_teleop_Joint3_fanuc-1.STL
mechanical/Zhonglin_servo/dual_arm/franka_teleop_Joint3_fanuc-3.STL
mechanical/Zhonglin_servo/dual_arm/franka_teleop_Link3_new-1.STL
mechanical/Zhonglin_servo/dual_arm/franka_teleop_joint fixshort-1.STL
mechanical/Zhonglin_servo/dual_arm/franka_teleop_joint fixshort-2.STL
mechanical/Zhonglin_servo/dual_arm/franka_teleop_joint4_support-2.STL
mechanical/Zhonglin_servo/dual_arm/franka_teleop_joint4_support-5.STL
mechanical/Zhonglin_servo/dual_arm/franka_teleop_joint4_support-6.STL
mechanical/Zhonglin_servo/dual_arm/franka_teleop_joint4_support-7.STL
mechanical/Zhonglin_servo/dual_arm/franka_teleop_joint4_support-8.STL
mechanical/Zhonglin_servo/dual_arm/franka_teleop_link_1-1.STL
mechanical/Zhonglin_servo/dual_arm/franka_teleop_link_1-3.STL
mechanical/Zhonglin_servo/dual_arm/franka_teleop_new - 臂1-1.STL
mechanical/Zhonglin_servo/dual_arm/franka_teleop_new - 臂1-3.STL
mechanical/Zhonglin_servo/dual_arm/franka_teleop_new - 臂3-2.STL
mechanical/Zhonglin_servo/dual_arm/franka_teleop_new - 臂3-4.STL
mechanical/Zhonglin_servo/dual_arm/franka_teleop_trigger_handle-1.STL
mechanical/Zhonglin_servo/dual_arm/franka_teleop_trigger_handle_new-1.STL
mechanical/Zhonglin_servo/dual_arm/franka_teleop_trigger_handle_new-2.STL
mechanical/Zhonglin_servo/dual_arm/franka_teleop_trigger_short-1.STL
src/simulation/mani_skill/assets/robots/ARX-X5/meshes/link1.STL
src/simulation/mani_skill/assets/robots/ARX-X5/meshes/link5.STL
src/simulation/mani_skill/assets/robots/ARX-X5/meshes/link6.STL
src/simulation/mani_skill/assets/robots/ARX-X5/meshes/link7-old.STL
src/simulation/mani_skill/assets/robots/ARX-X5/meshes/link7.STL
src/simulation/mani_skill/assets/robots/ARX-X5/meshes/link8-old.STL
src/simulation/mani_skill/assets/robots/ability_hand/meshes/collision/thumb-F1_C.obj
src/simulation/mani_skill/assets/robots/ability_hand/meshes/collision/wristmesh_C.obj
src/simulation/mani_skill/assets/robots/ability_hand/meshes/visual/idx-F1.obj
src/simulation/mani_skill/assets/robots/ability_hand/meshes/visual/thumb-F2.obj
src/simulation/mani_skill/assets/robots/ability_hand/meshes/visual/wristmesh.obj
src/simulation/mani_skill/assets/robots/allegro/meshes/visual/base_link.obj
src/simulation/mani_skill/assets/robots/allegro/meshes/visual/base_link_left.obj
src/simulation/mani_skill/assets/robots/allegro/meshes/visual/link_1.0.obj
src/simulation/mani_skill/assets/robots/allegro/meshes/visual/link_12.0_left.obj
src/simulation/mani_skill/assets/robots/allegro/meshes/visual/link_12.0_right.obj
src/simulation/mani_skill/assets/robots/allegro/meshes/visual/link_14.0.obj
src/simulation/mani_skill/assets/robots/allegro/meshes/visual/link_2.0.obj
src/simulation/mani_skill/assets/robots/allegro/meshes/visual/link_3.0.obj
src/simulation/mani_skill/assets/robots/fetch/fetch_description/meshes/base_link_collision.STL
src/simulation/mani_skill/assets/robots/fetch/fetch_description/meshes/bellows_link.STL
src/simulation/mani_skill/assets/robots/fetch/fetch_description/meshes/bellows_link_collision.STL
src/simulation/mani_skill/assets/robots/fetch/fetch_description/meshes/elbow_flex_link_collision.STL
src/simulation/mani_skill/assets/robots/fetch/fetch_description/meshes/estop_link.STL
src/simulation/mani_skill/assets/robots/fetch/fetch_description/meshes/gripper_link.STL
src/simulation/mani_skill/assets/robots/fetch/fetch_description/meshes/head_pan_link_collision.STL
src/simulation/mani_skill/assets/robots/fetch/fetch_description/meshes/head_tilt_link_collision.STL
src/simulation/mani_skill/assets/robots/fetch/fetch_description/meshes/l_wheel_link.STL
src/simulation/mani_skill/assets/robots/fetch/fetch_description/meshes/l_wheel_link_collision.STL
src/simulation/mani_skill/assets/robots/fetch/fetch_description/meshes/laser_link.STL
src/simulation/mani_skill/assets/robots/fetch/fetch_description/meshes/r_wheel_link.STL
src/simulation/mani_skill/assets/robots/fetch/fetch_description/meshes/r_wheel_link_collision.STL
src/simulation/mani_skill/assets/robots/fetch/fetch_description/meshes/shoulder_lift_link_collision.STL
src/simulation/mani_skill/assets/robots/fetch/fetch_description/meshes/torso_fixed_link.STL
src/simulation/mani_skill/assets/robots/fetch/fetch_description/meshes/torso_lift_link_collision.STL
src/simulation/mani_skill/assets/robots/fetch/fetch_description/meshes/upperarm_roll_link_collision.STL
src/simulation/mani_skill/assets/robots/fetch/fetch_description/meshes/wrist_roll_link_collision.STL
src/simulation/mani_skill/assets/robots/fetch_xlerobot/meshes/Base.stl.convex.stl
src/simulation/mani_skill/assets/robots/fetch_xlerobot/meshes/Base_Motor.stl
src/simulation/mani_skill/assets/robots/fetch_xlerobot/meshes/Base_Motor.stl.convex.stl
src/simulation/mani_skill/assets/robots/fetch_xlerobot/meshes/Fixed_Jaw.stl
src/simulation/mani_skill/assets/robots/fetch_xlerobot/meshes/Fixed_Jaw.stl.convex.stl
src/simulation/mani_skill/assets/robots/fetch_xlerobot/meshes/Fixed_Jaw_Motor.stl.convex.stl
src/simulation/mani_skill/assets/robots/fetch_xlerobot/meshes/Fixed_Jaw_part1.ply
src/simulation/mani_skill/assets/robots/fetch_xlerobot/meshes/Fixed_Jaw_part2.ply
src/simulation/mani_skill/assets/robots/fetch_xlerobot/meshes/Fixed_Jaw_part2.ply.convex.stl
src/simulation/mani_skill/assets/robots/fetch_xlerobot/meshes/Lower_Arm.stl
src/simulation/mani_skill/assets/robots/fetch_xlerobot/meshes/Lower_Arm_Motor.stl
src/simulation/mani_skill/assets/robots/fetch_xlerobot/meshes/Lower_Arm_Motor.stl.convex.stl
src/simulation/mani_skill/assets/robots/fetch_xlerobot/meshes/Moving_Jaw.stl
src/simulation/mani_skill/assets/robots/fetch_xlerobot/meshes/Moving_Jaw_part1.ply.convex.stl
src/simulation/mani_skill/assets/robots/fetch_xlerobot/meshes/Moving_Jaw_part2.ply
src/simulation/mani_skill/assets/robots/fetch_xlerobot/meshes/Moving_Jaw_part2.ply.convex.stl
src/simulation/mani_skill/assets/robots/fetch_xlerobot/meshes/Moving_Jaw_part3.ply
src/simulation/mani_skill/assets/robots/fetch_xlerobot/meshes/Moving_Jaw_part3.ply.convex.stl
src/simulation/mani_skill/assets/robots/fetch_xlerobot/meshes/Rotation_Pitch.stl
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
