CloudEngineHub/LeRobot-Anything-U-Arm/src/simulation/mani_skill/examples/bimanual.openarm/openarm_description/assets/robot/openarm_v2.0/config/meta.md

right arm with pinch gripper

right arm with pinch gripper

left arm with pinch gripper

left arm with pinch gripper

default bimanual

default bimanual

bimanual with grasp frame

bimanual with grasp frame
