CloudEngineHub/LeRobot-Anything-U-Arm/src/simulation/mani_skill/examples/bimanual.openarm/openarm_mujoco/media/v2.png

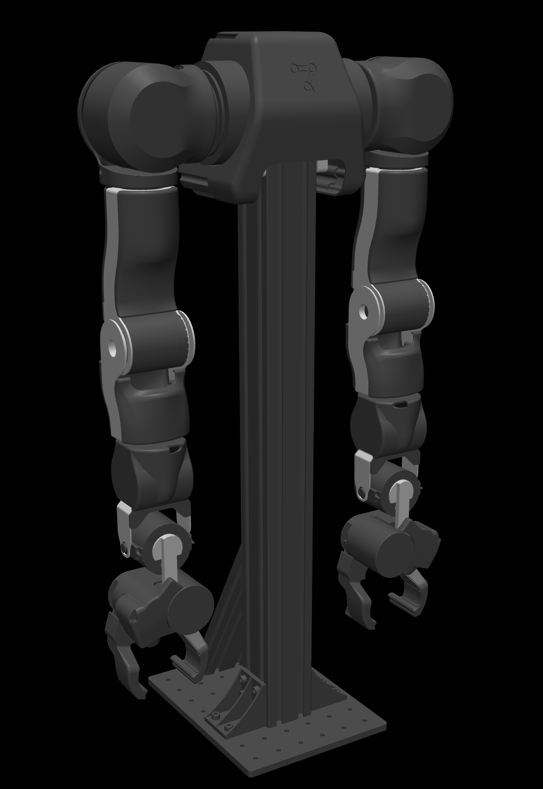
src/simulation/mani_skill/examples/bimanual.openarm/openarm_mujoco/media/v2.png
