CloudEngineHub/LeRobot-Anything-U-Arm/src/simulation/mani_skill/utils/building/assets/floor_tiles_06_diff_2k_aligned.png

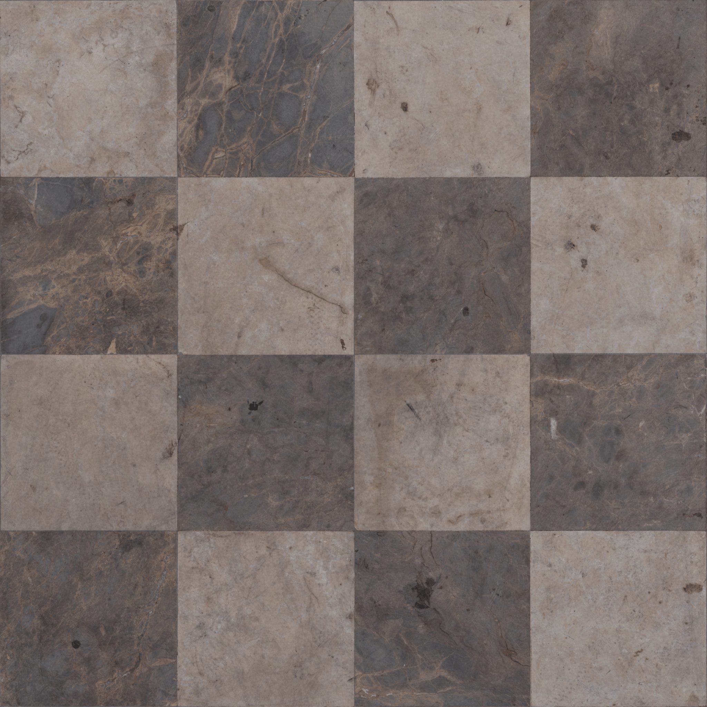
src/simulation/mani_skill/utils/building/assets/floor_tiles_06_diff_2k_aligned.png
