CloudEngineHub/LeRobot-Anything-U-Arm/src/simulation/mani_skill/utils/building/assets/grid_texture_thin.png

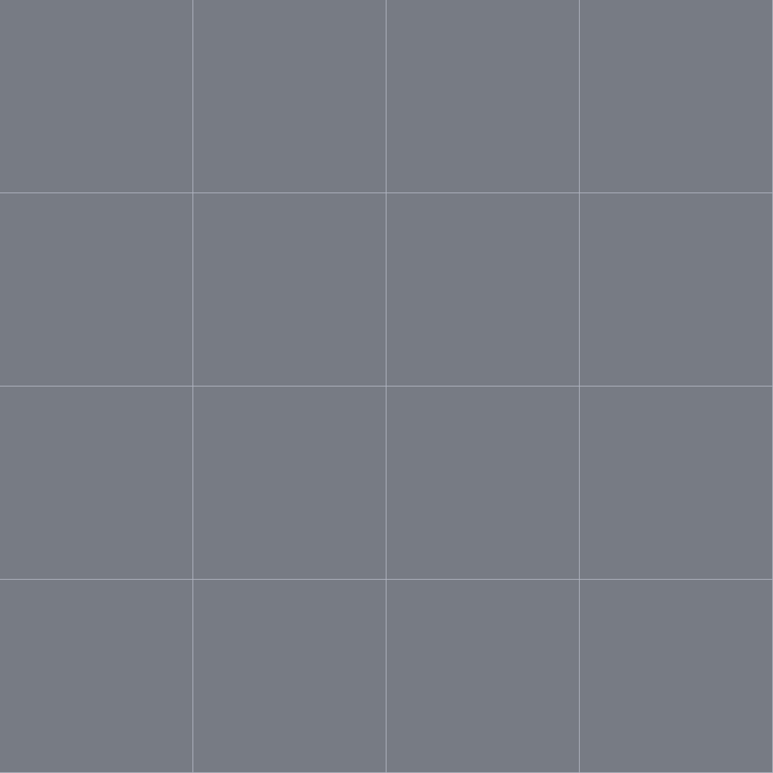
src/simulation/mani_skill/utils/building/assets/grid_texture_thin.png
