CloudEngineHub/LeRobot-Anything-U-Arm/(commit log)

2025-08-19 fix: fix teleop in arx-x5
    [arx_teleop.py]
2025-08-19 feat: add simulation feature
    [BL-M_Table_ASM_big.stl, BL-M_Table_ASM_small.stl, BL_Finger_Holder_SIM.stl, Base.stl, Base.stl.convex.stl, Base_Motor.stl, Base_Motor.stl.convex.stl, Body.stl]
2025-08-20 update README & fix CMAKE problem & fix scripts
    [arx_teleop.py, servo2xarm.py, servo_reader.py, servo_reader_fixed.py, servo_zero.py]
2026-01-23 add servo number check
2026-03-24 Add dual-arm STL files in mechanical/dual_arm
    [franka_teleop（openarm3）_new - 11-23_middle_bridge-1.STL, franka_teleop（openarm3）_new - Base_gen-1.STL, franka_teleop（openarm3）_new - Base_gen-3.STL, franka_teleop（openarm3）_new - Joint3_fanuc-1.STL, franka_teleop（openarm3）_new - Joint3_fanuc-3.STL, franka_teleop（openarm3）_new - Link3_new-1.STL, franka_teleop（openarm3）_new - Link3_new-2.STL, franka_teleop（openarm3）_new - joint fixshort-1.STL]
2026-03-24 Update README news section for dual-arm files
2026-03-24 Rename STL files for clarity
    [franka_teleop _Base_gen-1.STL, franka_teleop_ Link3_new-2.STL, franka_teleop_Base_gen-3.STL, franka_teleop_Joint3_fanuc-1.STL, franka_teleop_Joint3_fanuc-3.STL, franka_teleop_Link3_new-1.STL, franka_teleop_joint fixshort-1.STL, franka_teleop_joint fixshort-2.STL]
2026-03-25 Add dual-arm assembly STEP file
    [3-25-franka_teleop（openarm3）_new.STEP]
2026-03-25 rename STEP file
    [frank_teleop_humanoid_bimanual.STEP]
2026-03-25 Move STEP files to new folder
    [frank_teleop_humanoid_bimanual.STEP, franka_teleop _Base_gen-1.STL, franka_teleop_ Link3_new-2.STL, franka_teleop_Base_gen-3.STL, franka_teleop_Joint3_fanuc-1.STL, franka_teleop_Joint3_fanuc-3.STL, franka_teleop_Link3_new-1.STL, franka_teleop_joint fixshort-1.STL]
2026-07-15 Add bimanual openarm example
    [articulated_scene.xml, balance_scene.xml, base_link.stl, base_link_00.obj, base_link_01.obj, body_link0.stl, body_link0_0.obj, body_link0_1.obj]
