CloudEngineHub/LeRobot-Anything-U-Arm/(notices)

Notices in the files:
src/simulation/mani_skill/examples/bimanual.openarm/openarm_mujoco/v2/assets/visual/body/body_link0_5.obj:
Copyright 2026 Enactic, Inc.
Licensed under the Apache License, Version 2.0 (the "License");
